Gelow-serafind/Homogenizer-Proj-ES-motor/doc/审核报告.md

# 审核报告 — ES 电机驱动板文档体系

> 当前 UI 复核：2026-10-08，结论与逐项问题见第 8 节；下方 2026-09-14 审核为历史记录。
> 审核日期：2026-09-14
> 审核范围：《产品认知摘要.md》《需求细分拆解.md》《详细测试用例.md》《软件架构设计.md》《CLAUDE.md》与需求原文（`es电机需求文档v1-260830.docx`、《产品需求简述.md》）的覆盖与一致性。
> 审核结论：**通过**（附 6 项待办问题，见第 6 节）。

---

## 1. 需求原文 ↔ 需求细分拆解 覆盖核对

《需求细分拆解.md》附录 B 已建立逐条映射表，核对结果：

| 来源 | 条目数 | 已映射 | 结论 |
|---|---|---|---|
| docx 原文段落（D1~D9） | 9 | 9 | ✓ 无遗漏 |
| 简述 一（部件认知） | 6 | 6 | ✓ |
| 简述 二（工作流程） | 6 | 6 | ✓ |
| 简述 三（软件开发需求点 A~H，1~27） | 27 | 27 | ✓ |
| docx 附加图标（▲ 常亮） | 1 | 1 | ✓（REQ-ICON-06，A7） |
| **合计** | **49** | **49** | **100% 覆盖** |

反向核查：47 条 REQ 全部有原文出处（每条标注"来源"），无凭空新增；原文缺失项（归零行为、边界行为、默认值等）均已标注 `[ASSUMPTION]` 并收敛于 A1~A17。

## 2. 需求跟踪矩阵（REQ ↔ TC）核查

| 核查项 | 结果 |
|---|---|
| REQ 总数 / TC 总数 | 47 / 57 |
| 每个 REQ ≥ 1 条 TC | ✓（正向矩阵 C.1 逐条核对通过，无"裸需求"） |
| 每条 TC 回指 ≥ 1 条 REQ | ✓（反向矩阵 C.2 逐条核对通过，无"无主用例"） |
| 三类场景覆盖 | ✓ 正常流 38 / 边界值 11 / 异常流 8 |
| 任务书点名场景 | ✓ 运行中停止（TC-SM-08）、运行中改参数（TC-SM-09/TC-MOT-05/TC-TIMER-04）、探头拔出（TC-TEMP-03/04）、断电重启（TC-STOR-01/04/05）、时间上限 9999:59:59（TC-IN-07）、转速上下限（TC-IN-05/06）、10rpm 步进（TC-IN-01/02） |
| 矩阵排版错误 | 已修复（C.2 表初稿存在 TC-SM-02~05 重复行，已更正为 19×3 无重复版） |

## 3. 需求 → 架构落点核查（47 条 REQ 逐条）

| REQ | 主模块 | 协同模块 | REQ | 主模块 | 协同模块 |
|---|---|---|---|---|---|
| DISP-01 | display | app_state | TIMER-01 | timer | app_state, speed_sensor |
| DISP-02 | display | — | TIMER-02 | timer | app_state |
| DISP-03 | display | — | TIMER-03 | timer | app_state, display |
| DISP-04 | display | temp_sensor | TIMER-04 | timer | app_state, motor |
| DISP-05 | display | app_state | ICON-01 | display | temp_sensor |
| DISP-06 | display | temp_sensor | ICON-02 | display | timer |
| DISP-07 | display | 全模块状态源 | ICON-03 | display | speed_sensor/motor |
| IN-01 | button | app_state | ICON-04 | display | app_state |
| IN-02 | button | app_state | ICON-05 | display | — |
| IN-03 | button | app_state | ICON-06 | display | app_state |
| IN-04 | button | app_state | STOR-01 | storage | app_state |
| IN-05 | button | app_state | STOR-02 | storage | app_state |
| IN-06 | button | app_state | STOR-03 | storage | — |
| IN-07 | button | app_state | STOR-04 | storage | app_state |
| SM-01 | app_state | — | SYS-01 | main 调度+event_bus | 全部模块 |
| SM-02 | app_state | button, display | SYS-02 | main（IWDG） | — |
| SM-03 | app_state | storage, display | SYS-03 | app_state | display |
| SM-04 | app_state | motor, timer, storage | | | |
| SM-05 | app_state | motor, timer, display | | | |
| SM-06 | app_state | motor, display | | | |
| SM-07 | app_state | motor, timer, storage | | | |
| SM-08 | app_state | storage, display | | | |
| MOT-01 | motor | app_state（目标）, speed_sensor（反馈，经事件总线 EVT_SPEED_UPDATED 缓存） | | | |
| MOT-02 | speed_sensor | display, app_state | | | |
| MOT-03 | app_state | speed_sensor, timer | | | |
| MOT-04 | motor | speed_sensor, display | | | |
| MOT-05 | motor | app_state | | | |
| TEMP-01 | temp_sensor | display | | | |
| TEMP-02 | temp_sensor | display | | | |
| TEMP-03 | temp_sensor | display, app_state | | | |

**结论**：47 条 REQ 全部有明确归属模块，无"无归属模块的业务逻辑"。

## 4. 文档间一致性核查

| # | 核查项 | 结论 |
|---|---|---|
| 1 | 编号体系统一（REQ/TC/A 系列跨文档引用一致） | ✓ |
| 2 | 状态机命名统一（STANDBY/RUNNING/PAUSED + 编辑层 SPEED→TIME_H→TIME_M→TIME_S） | ✓（四份文档一致，且与现有代码 `AppMode_t/SettingField_t` 对齐） |
| 3 | 周期参数统一（500ms 闪烁、5s 超时、10kHz PWM、2/10/5/50ms 现有任务） | ✓ |
| 4 | 假设编号 A1~A17 在《认知摘要》《拆解》《测试用例》《CLAUDE.md》间引用一致 | ✓（17/17 均在拆解中实际引用） |
| 5 | 关键行为口径统一：到达判定（A12）、暂停/恢复（A11）、归零（A4）、确认写 Flash（A15） | ✓ |
| 6 | 架构的"按钮事件需同时分发"要求：通过订阅广播 + app_state 编排 + 派生事件实现，与 4.3/4.4 信号流转图一致 | ✓ |
| 7 | 调度表与模块 `_ops` 签名一一对应（8 个周期任务 + dispatch） | ✓ |
| 8 | CLAUDE.md 与架构文档无矛盾（硬件速查与架构第 10 节一致） | ✓ |

## 5. [ASSUMPTION] 汇总清单

| # | 假设内容 | 影响 REQ | 确认建议 |
|---|---|---|---|
| A1 | 转速下限取 100 | IN-05, MOT-01 | **优先与客户确认** |
| A2 | 时间分位编辑（SPEED→H→M→S→SPEED 循环） | IN-02, IN-06 | **优先确认** |
| A3 | "目标温度/set temp"为笔误，仅保存转速+时间 | STOR-01 | 与客户确认 |
| A4 | 倒计时归零→自动停机回待机、参数保留 | TIMER-04 | **优先确认** |
| A5 | 十字架=PT1000 在位 | TEMP-03, ICON-01 | 确认 |
| A6 | 转速/H 钳位，M/S 循环 | IN-07 | 确认 |
| A7 | S3 为警告，恒灭；无独立运行箭头 | ICON-06 | 确认 |
| A8 | 感叹号恒灭+报警接口预留 | ICON-04, SYS-03 | 确认 |
| A9 | 停止后转速自然衰减显示至 0 | MOT-04, SM-05 | 低风险 |
| A10 | 每转脉冲数配置常量，实测标定 | MOT-02 | 硬件标定 |
| A11 | 未改时间续冻结值，改时间重载 | SM-07, TIMER-02 | 确认 |
| A12 | 到达判定 ≤50 RPM 且持续 ≥1s（**2026-09-17 起仅信息事件；倒计时改 START 直启**） | MOT-03, TIMER-01 | 标定后调参 |
| A13 | 默认转速 100、时间 00:00:00 | STOR-02 | 确认 |
| A14 | SPEED 实时生效、TIME 确认后生效 | MOT-05, TIMER-03 | 低风险 |
| A15 | 确认即写 Flash（单击/5s/START） | STOR-04 | 低风险 |
| A16 | 右上角 4 个图标 + 隔断线（按规格图纠正） | DISP-01 | 已按原文裁定 |
| A17 | 非编辑态旋转旋钮无效 | IN-07 | 低风险 |

## 6. 发现问题与遗留事项

| # | 问题 | 等级 | 处理建议 |
|---|---|---|---|
| I1 | `AGENTS.md` 仍描述旧板（TM1729/17.57kHz/长按启停），与本套文档冲突 | 中 | 本任务未授权修改；建议下次提交时同步或归档，避免误导 Codex |
| I2 | 用例 TC-MOT-01/02/03、TC-TEMP-01 依赖硬件与标定 | 中 | **R1 已关闭**（测速链路验证通 2026-09-14）、**A10 已关闭**（18 计数/圈，2026-09-15）；速度环已落地（2026-09-15）；**温度链路已实装**（2026-09-15 比值法+查表；段位校准完成 2026-09-16；**2026-10-01 探头接入，切实值显示待上板精度核对**；R2 通道归属关闭）；剩余 R7 LUT 标定、Kp/Ki 上板整定 |
| I3 | 现有代码为单文件 `main.c`（STEP3 实现），事件总线/模块拆分尚未落地 | 中 | 按架构第 11 节"迁移策略"逐模块切分，每步保持可编译、行为等价，同步更新 Keil `Project.uvprojx` |
| I4 | 到达判定当前用模型值 `MotorRpm==ConfigRpm`，非真实测速 | 高 | **已解决（2026-09-15）**：到达判定切换 speed_sensor 实测转速 + A12 容差（|实际−目标|≤50 RPM 持续 1s，`REACH_TOLERANCE_RPM/REACH_HOLD_MS`）；速度环（FF+PI，20ms/Q8）同批落地，反馈经 EVT_SPEED_UPDATED 订阅缓存；shell 新增 pid/pidkp/pidki 供上板整定 |
| I5 | 旧“30/30 图标全匹配”结论撤回（2026-10-08） | 中 | 规格图证实 S1/S2 对调、S3 误认运行箭头；已修正代码与文档并完成主机回归，待 Keil 编译与上板复核，详见第 8 节 |
| I6 | 17 项假设未获客户背书 | 中 | A1/A2/A4/A11 四项优先书面确认，确认结果回填《认知摘要》并在 `app_cfg.h` 单点落地 |

## 7. 结论

- 需求原文 49 个条目 100% 覆盖（47 条 REQ）；
- 47 REQ ↔ 58 TC 双向跟踪矩阵完整（2026-09-15 新增 TC-MOT-06 闭环动态响应），无裸需求、无无主用例；
- 47 条 REQ 全部在架构中有模块落点；
- 六份文档（含本报告）编号、命名、周期、假设引用一致；
- 遗留风险为 LUT 标定（R7）、Kp/Ki 上板整定与 4 项关键假设确认，均不阻塞编码，已列入待办。

**审核通过，可进入开发阶段。**

## 8. 2026-10-08 代码全盘走读与 UI 修复记录

### 8.1 范围与裁决依据

走读应用入口/调度、event_bus、app_state、display、button、motor、speed_sensor、temp_sensor、timer、storage，以及 ht1623、ads1115、ec11、flash_wear、uart_cmd。核对原始 docx 文本、六份需求/架构/测试文档和 LVD13083AVTP1 规格书第 3 页的图案/引脚矩阵。供应商 CMSIS/外设库作为平台依赖，未做逐行独立审计。

用户本次决策优先：暂停只关闭时钟与圆，Set Speed 保持显示；后续明确“需求未定义故障，先不显示感叹号”。因此本次不新增故障判断。正常拔出探头继续按既有需求隐藏温度和十字架。Instant Speed 沿用 A9 随实测衰减，不伪造瞬间静止。

### 8.2 已发现并修复的问题

| # | 错误与证据 | 修改 | 需求 / 测试 |
|---|---|---|---|
| UI-01 | S1/S2 角色对调：原 iconBind 时钟=1，常显标签=2；规格图 S1=Set Speed、S2=时钟。造成暂停标签灭、时钟常亮 | 常显标签改 S1，时钟改 S2 | DISP-01/07、ICON-02/06；TC-ICON-02/06 |
| UI-02 | S3 警告三角被当作“运行箭头”，正常 RUNNING 反而亮；警告 ROLE_WARN 绑定 0 | S3 绑定警告并恒灭，删除虚构的运行箭头角色；撤回旧“玻璃无感叹号”记录 | ICON-04/06；TC-ICON-04/06 |
| UI-03 | 圆只按平滑转速判亮，暂停后惯性阶段仍亮 | 圆=RUNNING 且实测转速>0，暂停/待机立即灭 | SM-05、ICON-03；TC-SM-08/ICON-03 |
| UI-04 | 时钟只看 RUNNING，时间为 0、不倒计时时仍亮 | 同时要求 timer active；非零时间 START 即亮 | ICON-02；TC-ICON-02/TIMER-06 |
| UI-05 | timer 只在进入秒处理前已为 0 时发归零事件，1→0 后多运行一秒 | 递减后当拍判零，下一状态机周期停机并关闭图标 | TIMER-04；TC-TIMER-05 |
| UI-06 | app_enter_edit 清 timeEdited：暂停改时间确认后，再进速度编辑会丢失重载标志 | 标志保留到 START 消费；未改时间仍续冻结值 | SM-07/TIMER-02；TC-SM-10/11 |
| UI-07 | 单击换字段只改 edit，未按 A15 确认保存；时间也没有确认生效 | 跳字段前 app_commit；时间只在改过时重载 | IN-02/STOR-04/TIMER-03；TC-IN-04/STOR-01/TIMER-04 |
| UI-08 | 首次/无效存储回显 0 RPM，与 A13/REQ-STOR-02 的 100 不一致 | 默认 RPM_MIN；旧记录低于下限时规范为 100，保留有效时间 | STOR-02；TC-STOR-02 |
| UI-09 | 吸附态使用最新 cfgRpm 绘制，改目标时会直接跳到新目标；原始零速还可能保持旧目标 4 拍 | 目标变化/零速立即退出旧吸附并对齐实测；重新满足条件后再吸附 | DISP-02；TC-DISP-02 扩展 |
| UI-10 | 每次 lcd_set_segment 都置 dirty，memcmp 相同没有清零，稳定画面仍每 50ms 写屏 | 用整帧比较结果覆盖 dirty；手动调试切回 auto 强制重写仍保留 | DISP-07/SYS-01；TC-SYS-01 扩展 |
| UI-11 | display 直接调用多个业务 getter，违反仅 app_state 白名单直调的架构要求 | app_state 10ms 汇总 display_view_t，display_set_view 复制；display 50ms 只渲染快照 | DISP-07/SYS-01；架构第 3/8 节 |
| UI-12 | 两 word 保存均读取可变 pending：快速再次确认时，可能把上一组 rpm/h 与下一组 m/s 混写；无变化确认也消耗槽 | 增加固定 writing 快照，新请求下一轮写；已完成且参数相同则跳过 | STOR-04；TC-STOR-04 扩展 |

其余 UI 核对：Set Speed/Instant Speed 右对齐与 Rpm、Set Time/Remaining 的 H4:M2:S2、500ms 编辑分位闪烁、5s 超时、START/STOP 退出闪烁、温度小数点/℃/标签随探头、隔断线常显，均保留并加入回归。纠正文档“100 的高两位熄灭”为最高一位熄灭。吸附宏实际为 ±5 RPM，文档旧写 ±2；本次保留固件现有阈值 5，仅同步注释/说明。

### 8.3 修正后的状态表

| 元素 | 待机 | 运行 | 暂停 |
|---|---|---|---|
| Set Speed 标签 S1、Rpm、设定数字 | 显示 | 显示 | 显示 |
| 时钟 S2 | 灭 | 非零倒计时 active 时亮 | 灭 |
| 感叹号 S3 | 灭 | 灭 | 灭 |
| 圆 S4 | 灭 | 实测 >0 时亮 | 立即灭（不等惯性停止） |
| 十字架 S30、温度区 | 随探头在位 | 随探头在位 | 随探头在位、继续测温 |
| Remaining | 启动前/归零后为 0 | 逐秒递减 | 冻结保持 |
| Instant Speed | 实测 | 实测平滑/吸附 | 实测衰减至 0 |

任一主状态下主动进入设置，仅当前数字字段闪烁；标签始终显示。

### 8.4 验证与未完成的硬件验收

- `python3 tests/test_ui.py`：编译真实 display/app_state/timer/storage/event_bus，替换 MCU/LCD/Flash/测速/温度硬件接口。通过 120 组状态/编辑/闪烁/探头/计时组合；按规格书坐标校验全部 28 位数字与 30 个图标；覆盖 0~9 字模及时间/温度边界、暂停惯性、冻结恢复、归零同拍、时间重载、单击持久化、5s 超时、吸附复位、稳定帧不重复写屏、调试恢复、并发确认快照与旧参数回显。
- `python3 tests/check_syntax.py`：按 Keil 工程 IncludePath/Define 对全部应用/入口/异常源文件运行 clang C99 语法检查；屏蔽宿主机 64 位与 CMSIS ARM 内联汇编宽度差异警告。此检查不汇编、不链接。
- **尚未执行**：Keil ARMCLANG V6.22 `-Oz` 完整编译、Flash/SRAM 剩余空间检查、烧录与 LCD 实物目视验收；当前环境无 Keil。未修改优化等级、引脚、PWM/PID，也未生成新的 hex/axf。
- 上板优先序列：待机→非零时间 START→仍有惯性时 STOP→恢复→归零；再测零时间运行、主动编辑闪烁、PT1000 拔插。S1/S2/S3 是此次必须复核的物理段位。

### 8.5 走读发现的既有遗留（未在本次 UI 修复中扩展）

- 温度 I2C 读取失败保持上次值，不能据当前软件区分“仍在位”与“读数过期”；故障范围尚未定义，本次未引入报警或新的温度故障界面。
- ADS1115 单次采样和 HT1623 位操作存在阻塞等待；本次修掉稳定屏重复发送，未重写外设驱动为异步状态机。
- 倒计时秒事件来自全局 housekeeping，START 首个显示秒的时长受全局相位影响；本次修正末秒停机延后，未改全局时基。
- IWDG 仍是 TODO；报警框架未实现；速度环 Kp/Ki、新电机 LUT 与温度精度仍需上板验收。既有 Flash 写满擦页的掉电窗口仍需硬件/存储设计专项验证。
- 此前“30/30 全匹配”的图标验收结论已撤回，当前修订依据规格图与主机段位回归，不能冒充上板通过。
