Gelow-serafind/Homogenizer-Proj-ES-motor/doc/需求细分拆解.md

# 需求细分拆解 — ES 电机驱动板

> **定位**：本文档是开发的唯一指导文档。完成的定义 = 完全覆盖《产品需求简述》的全部内容。
> **上游依据**：`doc/产品需求简述.md`（含 docx 原文摘录）、`doc/产品认知摘要.md`（歧义与假设清单 A1~A17）。
> **下游**：《详细测试用例.md》（每 REQ ≥ 1 条 TC）、《软件架构设计.md》（每 REQ 有模块落点）。
>
> **编号规则**：`REQ-<域>-<序号>`，域：DISP 显示 / IN 输入 / SM 状态机 / MOT 电机与测速 / TEMP 温度 / TIMER 倒计时 / ICON 图标 / STOR 存储 / SYS 系统级。
> **优先级**：P0 = 必须（缺失则产品不可用）；P1 = 应该（重要但可后期补）；P2 = 可选（预留/增强）。
> **假设标注**：涉及文档歧义的条目标注 `[ASSUMPTION An]`，编号与《产品认知摘要》第 4 节一致。
> **需求总量**：47 条。覆盖性核对表见文末附录 B。

---

## 1. 显示域（DISP）

### REQ-DISP-01 界面布局
- **描述**：屏面由 4 组数据区（Set Speed；Set Time；Instant Speed + Instant Temp；Remaining Time）、右上角图标区与常显隔断线组成。
- **来源**：简述 一「OLED 显示屏 显示 4 组数据区…+ 右上角 5 个状态图标区」；简述 三A-1「屏幕驱动与界面布局（4 数据区 + 图标区 + 隔断线常显）」。
- **验收标准**：上电后目视可见全部 4 组数据区标签与数字区、图标区、隔断线常亮（任何状态下）。
- **优先级**：P0
- **假设**：无（右上角 4 个图标及隔断线，见 [ASSUMPTION A16]）。

### REQ-DISP-02 转速字段格式
- **描述**：Set Speed 与 Instant Speed 均以 4 位数字 + `Rpm` 单位段显示，数字右对齐，高位空位熄灭。
- **来源**：简述 三A-2「字段格式化：转速 4 位 + "Rpm"」。
- **验收标准**：设定/显示 2000 → `2000Rpm`；100 → 最高一位熄灭 + `100Rpm`；单位段 `Rpm` 常显。
- **优先级**：P0
- **假设**：无。

### REQ-DISP-03 时间字段格式
- **描述**：Set Time 与 Remaining Time 按 `H(≤4位) m(2位) s(2位)` 显示，H/m/s 单位段按屏丝印点亮。
- **来源**：简述 三A-2「时间 HHHH H MM m SS s」；docx「倒计时时间最大：9999.59.59」。
- **验收标准**：设定 1:23:45 → H=0001、m=23、s=45；设定 9999:59:59 → 全字段正确显示；单位段常显。
- **优先级**：P0
- **假设**：无。

### REQ-DISP-04 温度字段格式
- **描述**：Instant Temp 按 `888.8℃` 格式显示（3 位整数 + 小数点 + 1 位小数 + ℃ 单位段）。
- **来源**：简述 一「PT1000 测温探头…格式 888.8℃」；简述 三A-2「温度 888.8℃」。
- **验收标准**：25.6℃ → 显示 ` 25.6℃`（高位空位熄灭）；小数位与 ℃ 段正确点亮。
- **优先级**：P0
- **假设**：无。

### REQ-DISP-05 编辑参数闪烁
- **描述**：进入设置后，当前编辑字段以 500ms 周期闪烁（亮/灭交替）；确认（单击跳字段 / 按 START / 5s 超时）后停止闪烁。
- **来源**：简述 二.2「数值闪烁」「任一参数闪烁 5 秒无操作 → 自动确认写入，停止闪烁」；简述 三A-3。
- **验收标准**：编辑字段按约 0.5s 周期可视闪烁，非编辑字段不闪烁；确认后闪烁停止且字段显示新值。
- **优先级**：P0
- **假设**：无。

### REQ-DISP-06 温度整块隐藏
- **描述**：PT1000 拔出时，Instant Temp 的 `888.8℃` 数字连同标签整块熄灭；探头插回后恢复显示当前温度。
- **来源**：简述 三A-4；docx「如果拔掉了PT1000，字符"instant temp 888.8°C"全不显示」。
- **验收标准**：拔出探头 → 温度数字、标签、℃ 段全部熄灭；插回 → 恢复显示且数值为当前读数。
- **优先级**：P0
- **假设**：无（隐藏判定依赖 REQ-TEMP-03 开路检测）。

### REQ-DISP-07 图标渲染联动
- **描述**：图标区渲染由系统状态事件驱动，状态逻辑遵循 REQ-ICON-01 ~ REQ-ICON-06。
- **来源**：简述 三A-5「图标渲染与状态联动（见 E）」。
- **验收标准**：图标状态变化与对应状态事件一致（以 REQ-ICON 系列验收标准为准）。
- **优先级**：P0
- **假设**：无。

---

## 2. 输入域（IN）

### REQ-IN-01 旋钮旋转解码
- **描述**：EC11 正交解码（4 倍频），顺时针产生 +1 增量、逆时针产生 −1 增量，带去抖；增量只作用于当前编辑字段。
- **来源**：简述 一「旋转=改参数（顺时针增大/逆时针减小）」；简述 三B-6「编码器旋转解码（CW+/CCW−、防抖、只作用于当前闪烁参数）」。
- **验收标准**：每格旋转对应 +1/−1 增量（speed 字段 ±10 RPM）；快速连续旋转不丢步、不误判方向。
- **优先级**：P0
- **假设**：无。

### REQ-IN-02 旋钮单击切换字段
- **描述**：非编辑状态下单击旋钮进入设置并编辑 SPEED；编辑状态下单击确认当前字段并切换到下一字段，循环顺序 SPEED → TIME_H → TIME_M → TIME_S → SPEED。
- **来源**：简述 一「单击=确认并跳到下一个参数」；简述 三B-7「旋钮短按：确认并跳下一参数（speed → time → speed 循环）」。
- **验收标准**：连续单击 4 次完成一个字段循环；每次单击后闪烁位置与顺序一致。
- **优先级**：P0
- **假设**：时间分位循环按 [ASSUMPTION A2]；进入设置的完整路径见 REQ-SM-02/06/07。

### REQ-IN-03 START 键扫描去抖
- **描述**：START 键（PA2，低有效）扫描去抖，按下沿产生唯一"开始"事件，长按不重复触发。
- **来源**：简述 三B-8「START / STOP 按键扫描去抖」；docx「"开始"设置为参数后，按下开始工作」。
- **验收标准**：单次按下只产生 1 次事件；连按/抖动不产生重复或漏触发；长按 3s 以上仍只触发 1 次。
- **优先级**：P0
- **假设**：无。

### REQ-IN-04 STOP 键扫描去抖
- **描述**：STOP 键（PD7，低有效）扫描去抖，按下沿产生唯一"停止/暂停"事件。
- **来源**：简述 三B-8；docx「"停止"运动中停止」。
- **验收标准**：同 REQ-IN-03 的判定方式。
- **优先级**：P0
- **假设**：无。

### REQ-IN-05 转速范围与步进
- **描述**：目标转速范围 100 ~ 2000 RPM，步进 10 RPM。
- **来源**：简述 三B-9「数值范围约束：转速 100/200~2000、步进 10rpm」；docx「电机转速范围：100/200~2000，加减最小细分10rpm」。
- **验收标准**：每次旋转 ±10 RPM；最小可设定 100、最大 2000；中间值可精确到达（如 1010）。
- **优先级**：P0
- **假设**：下限取 100 见 [ASSUMPTION A1]。

### REQ-IN-06 时间范围与编辑
- **描述**：倒计时时间上限 9999:59:59；H（0~9999）、M（0~59）、S（0~59）分位独立编辑。
- **来源**：简述 三B-9「时间上限 9999:59:59」；docx「倒计时时间最大：9999.59.59」。
- **验收标准**：可设定并显示 9999:59:59；各分位可独立加减。
- **优先级**：P0
- **假设**：分位编辑见 [ASSUMPTION A2]；边界行为见 REQ-IN-07 与 [ASSUMPTION A6]。

### REQ-IN-07 编辑边界与非编辑态行为
- **描述**：转速到边界后继续旋转保持钳位（不循环）；H 钳位 0~9999；M/S 在 0~59 循环；非编辑状态下旋转旋钮无效。
- **来源**：文档未定义（歧义缺失项）。
- **验收标准**：在 100 处逆时针、2000 处顺时针，数值保持不变；M/S 59 再加变 0、0 再减变 59；待机/运行非编辑态旋转，所有参数与显示不变。
- **优先级**：P1
- **假设**：[ASSUMPTION A6]、[ASSUMPTION A17]。

---

## 3. 主状态机域（SM）

### REQ-SM-01 状态集合
- **描述**：系统状态由主模式（STANDBY / RUNNING / PAUSED）与编辑叠加层（EDIT_NONE / EDIT_SPEED / EDIT_TIME_H / EDIT_TIME_M / EDIT_TIME_S）正交组成；编辑层可在任一主模式下激活。
- **来源**：简述 三C-10「主状态机：待机 → 参数编辑（speed/time 子状态）→ 运行 → 运行中编辑 → 停止/暂停」。
- **验收标准**：任何时刻系统处于且仅处于一个主模式 + 一个编辑层状态（共 3×5=15 组合），观察行为与状态定义一致。
- **优先级**：P0
- **假设**：无。

### REQ-SM-02 进入设置
- **描述**：非编辑状态下单击旋钮 → 进入编辑层，SPEED 字段闪烁（待机/暂停/运行中均可用；运行中电机保持原目标运行）。
- **来源**：简述 二.2、二.4、二.5；docx「首次开机，单击旋钮，进入Set speed设置」。
- **验收标准**：待机单击 → SPEED 闪；暂停单击 → SPEED 闪；运行中单击 → SPEED 闪且电机不停止。
- **优先级**：P0
- **假设**：无。

### REQ-SM-03 5s 无操作自动确认
- **描述**：编辑状态下 5s 无任何操作（旋转/单击均重置计时）→ 自动确认写入、停止闪烁、退出编辑层（回到进入前的主模式）。
- **来源**：简述 二.2、三C-13；docx「如果参数闪烁5s，也表示确认参数写入，停止闪烁」。
- **验收标准**：最后一次操作后 5s ±0.5s 停闪退出；旋转或单击后重新计时满 5s 才退出；退出后参数已持久化。
- **优先级**：P0
- **假设**：无。

### REQ-SM-04 START 全局启动
- **描述**：任意状态（含参数闪烁中）按 START → 立即启动/恢复运行：确认写入、停止闪烁、退出编辑层、电机向目标转速运行。
- **来源**：简述 三C-11「全局规则：任意闪烁状态下按 START 即启动」；docx「不管它在哪个参数在闪，只要按了开始，然后它就能启动」。
- **验收标准**：待机/设置中/暂停三种时刻按 START 均能启动或恢复，闪烁立即停止，无延迟。
- **优先级**：P0
- **假设**：无。

### REQ-SM-05 运行中 STOP 暂停
- **描述**：RUNNING 状态下按 STOP → 进入 PAUSED：电机停转、倒计时冻结、时钟/圆 图标熄灭、实时温度继续显示、实时转速衰减显示至 0。
- **来源**：简述 二.5；docx「运动中单击停止键，设备电机停止…倒计时的时间暂停」。
- **验收标准**：按 STOP 后电机停转（PWM 输出归零），图标按上述联动，剩余时间保持按下时刻的值不变。
- **优先级**：P0
- **假设**：转速显示衰减见 [ASSUMPTION A9]。

### REQ-SM-06 运行中进入设置（电机不停）
- **描述**：RUNNING 状态下单击旋钮 → 进入编辑层，电机按原目标继续运行；退出编辑层前电机行为不受编辑影响（除 SPEED 实时跟随，见 REQ-MOT-05）。
- **来源**：简述 二.4；docx「运行中，按下旋钮键，进入设置参数界面」。
- **验收标准**：进入/退出编辑层全程电机不停止；不改参数时实际转速无变化。
- **优先级**：P0
- **假设**：无。

### REQ-SM-07 暂停后的转换路径
- **描述**：PAUSED 状态下：单击旋钮 → 进入设置，改了哪个参数就按哪个新参数执行；直接按 START → 按当前目标继续工作。
- **来源**：简述 三C-12「停止 → 进设置 → 改参数 → 再启动的转换路径」；docx「改了其中的参数就按新参数重新运行，直接点开始键，就开始工作」。
- **验收标准**：暂停中改转速后 START → 按新转速运行；暂停中改时间后 START → 倒计时按新值重载；未改直接 START → 按原目标继续（倒计时从冻结值继续，见 A11）。
- **优先级**：P0
- **假设**：[ASSUMPTION A11]。

### REQ-SM-08 上电初始状态
- **描述**：上电 → STANDBY，不自动启动；回显上次目标转速/时间；实时转速 0、倒计时 0、实时温度当前读数；图标：十字架按探头实况、时钟/圆 灭、隔断线常显、感叹号不显示。
- **来源**：简述 二.1、二.6；docx「二次开机…客户直接点击开始键，设备可以直接开始工作」。
- **验收标准**：上电后电机不转，显示与图标状态符合上述，按 START 即可直接启动。
- **优先级**：P0
- **假设**：无。

---

## 4. 电机控制与测速域（MOT）

### REQ-MOT-01 转速闭环控制
- **描述**：目标转速 100~2000 RPM、分辨率 10 RPM；闭环使实际转速稳定跟随目标（PWM 10kHz、TIM1_CH2；RPM-占空比 LUT 标定）。**实现方案（2026-09-15 落地）**：FF(LUT 前馈) + PI 反馈并联结构，20ms 节拍（与测速反馈同频）、Q8 定点无浮点；反馈经事件总线订阅 EVT_SPEED_UPDATED 缓存（motor_on_event）；参考轨迹=原 ramp（1000 RPM/s，启动无阶跃；**2026-09-17 修复：STOP 后重启动按实测转速复位，消除大电流猛启动**）；积分限幅抗饱和、输出限幅 SPEED_LOOP_DUTY_MAX（兼堵转保护）；Kp/Ki 常量集中 app_cfg.h 并经 shell pidkp/pidki 上板整定。
- **来源**：简述 三D-14「转速闭环控制（目标范围、10rpm 分辨率）」；docx「电机转速范围：100/200~2000，加减最小细分10rpm」。
- **验收标准**：各档位（如 100/500/1000/2000）稳态下实测转速在标定容差内（±5% 或标定值）；10 RPM 一档变化可分辨。
- **优先级**：P0
- **假设**：[ASSUMPTION A1]。

### REQ-MOT-02 光电测速
- **描述**：采集光耦脉冲信号，按每转脉冲数换算 RPM，滤波后刷新 Instant Speed。
- **来源**：简述 一「光电测速 检测电机实际转速，推算实时 RPM」；简述 三D-15「光电信号测速、RPM 推算与滤波」；docx「instant speed实时检测速度，由光电信号检测推算」。
- **验收标准**：低速手转电机与运行状态下，Instant Speed 与外部参考转速计一致（±容差），刷新连续无明显跳变。
- **优先级**：P0
- **假设**：每转脉冲数配置见 [ASSUMPTION A10]。

### REQ-MOT-03 到达目标判定
- **描述**：实际转速达到目标值（|实际−目标| ≤ 容差且持续 ≥ 稳定时间）→ post(EVT_REACH_TARGET) 信息事件（当前无消费方，供后续功能如到达提示使用）。
- **来源**：简述 二.3「实际转速到达目标值后，剩余时间才从设定值开始倒计时」；简述 三D-16。**2026-09-17 用户上板实测决策**：倒计时改为 START 直启，到达判定不再触发倒计时（事件保留）。
- **验收标准**：到达瞬间不引起倒计时/显示/电机任何跳变；事件在 |实际−目标|≤50 RPM 持续 1s 时发布（内部回归验证）。
- **优先级**：P1（原 P0；倒计时不再依赖，2026-09-17 降级）
- **假设**：[ASSUMPTION A12]（容差 50 RPM / 持续 1s，初值）。

### REQ-MOT-04 停止控制
- **描述**：STOP 后电机受控停转（PWM 归零），Instant Speed 随测速自然衰减显示至 0，圆图标在 STOP 进入暂停后立即熄灭（2026-10-08 用户决策）。
- **来源**：简述 三D-17「停机控制（STOP 后受控停转，转速显示归 0）」；docx「转速实时显示直到显示0」。
- **验收标准**：按 STOP 后电机停转，Instant Speed 由当前值连续衰减至 0（不瞬时跳 0），圆图标熄灭。
- **优先级**：P0
- **假设**：[ASSUMPTION A9]。

### REQ-MOT-05 运行中目标转速平滑跟随
- **描述**：运行中编辑 SPEED，每步 ±10 RPM 立即更新目标，闭环平滑过渡（斜坡逼近），无停机、无阶跃突变。
- **来源**：简述 三D-18「运行中目标转速变更的平滑跟随」；docx「SPEED参数闪烁，转速根据参数变化」。
- **验收标准**：运行中旋转旋钮，实际转速连续平滑变化至新目标，全程电机不停止、占空比无突变。
- **优先级**：P0
- **假设**：[ASSUMPTION A14]。

---

## 5. 温度采集域（TEMP）

### REQ-TEMP-01 PT1000 采集
- **描述**：采集 PT1000 分压信号，反推阻值换算温度，分辨率 0.1℃，按 888.8℃ 格式显示。
- **实现（2026-09-15；2026-10-01 探头接入切实值显示）**：原理图核实电路 = VCC_5V—R16(1k)—ADC_PT1000+（CN3）—GND，AIN0=探头节点、AIN1=R19/R18 基准中点；**比值法** `R_t=1000×A0/(2×A1−A0)`（免疫电源波动）；温度 = IEC 60751 生成表（0~300℃/5℃ 步进）+ 线性插值（℃，×10 定点，零浮点）；0.1℃ 小数点段 S28/℃ 段 S29 已实测绑定（2026-09-16）；`TEMP_DISPLAY_PLACEHOLDER` 已切 0 显示实测值（拔出整块隐藏）。
- **来源**：简述 三F-19「PT1000 采集、0.1℃ 分辨率」；docx「PT1000的实时温度读取」。
- **验收标准**：温度显示与标准温度计（或精密电阻标定）偏差 ≤ ±1℃；最小显示单位 0.1℃。
- **优先级**：P0
- **假设**：无。

### REQ-TEMP-02 全状态实时刷新
- **描述**：待机/设置/运行/暂停所有状态下，温度均按周期持续刷新。
- **来源**：简述 三F-19「全状态实时刷新」；简述 二.5「实时温度继续正常显示」。
- **验收标准**：运行与暂停期间用手温改变探头温度，显示值随之变化（刷新周期 ≤1s）。
- **优先级**：P0
- **假设**：无。

### REQ-TEMP-03 探头在位检测
- **描述**：通过 ADC 开路电压阈值判定探头插入/拔出；拔出 → 温度字段整块隐藏 + 十字架图标灭；插入 → 恢复显示 + 十字架亮。
- **来源**：简述 三F-20「探头在位检测（联动 E/F 的隐藏逻辑）」；docx「"十字架"传感器，插入就亮，不插就不亮」。
- **验收标准**：拔插探头，显示与图标在 ≤1s 内联动切换。
- **优先级**：P0
- **假设**：[ASSUMPTION A5]。

---

## 6. 倒计时域（TIMER）

### REQ-TIMER-01 启动条件
- **描述**：倒计时在按 START（进入 RUNNING）时立即启动：全新启动从设定值开始、暂停恢复从冻结值继续、改过时间按新值重载；启动后每秒递减 1s；时间为 0:00:00 时不递减（无计时作业，也不触发归零）。
- **来源**：简述 三G-21「启动条件：转速到达目标值后才倒数」；docx「Remaining time 运行后，速度到目标值的开始倒计时」。**2026-09-17 用户上板实测决策变更**：改为"点击 START 立即开始倒计时，点击 STOP 停止倒计时"（不再等待转速到达）。
- **验收标准**：按 START 后 ≤1s 内 Remaining 开始按 1Hz 递减（不等转速到达）；按 STOP 立即冻结；时间设 0 时启动不倒数、不归零。
- **优先级**：P0
- **假设**：[ASSUMPTION A12]（判定保留为信息事件，不再触发倒计时）。

### REQ-TIMER-02 暂停保持
- **描述**：STOP 后倒计时暂停并保持当前剩余值，不清零。
- **来源**：简述 三G-22「停止时暂停并保持剩余值」；docx「倒计时的时间暂停」。
- **验收标准**：暂停后等待 ≥10s，Remaining Time 显示值与暂停时刻完全一致。
- **优先级**：P0
- **假设**：无。

### REQ-TIMER-03 运行中改时间刷新
- **描述**：运行中修改时间并确认（单击跳字段/5s 超时/STOP/START）后，倒计时按新值重载并从新值立即继续递减。
- **来源**：简述 三G-23「运行中改时间后，退出设置界面时倒计时刷新」；docx「设置了time，也是按实时参数写入…退出设置界面，实时速度和实时倒计时需要更新」。
- **验收标准**：运行中把时间从 00:10:00 改为 00:05:00，退出编辑后 Remaining Time 立即显示 00:05:00 并从新值继续逐秒递减。
- **优先级**：P0
- **假设**：[ASSUMPTION A14]。

### REQ-TIMER-04 归零行为
- **描述**：倒计时归零 → 自动停机：电机停转、倒计时保持 0、状态回 STANDBY、设定参数保留；时钟/圆 图标熄灭。
- **来源**：文档未定义（简述 G-24 缺失项）。
- **验收标准**：归零瞬间电机停转，状态机回到待机；可再次按 START 按原参数重新工作。
- **优先级**：P1
- **假设**：[ASSUMPTION A4]。

---

## 7. 图标逻辑域（ICON）

### REQ-ICON-01 十字架
- **描述**：十字架图标 = PT1000 探头插入状态：插入亮、拔出灭。
- **来源**：简述 E 图标表「传感器插入检测，插则亮、拔则灭」。
- **验收标准**：与 REQ-TEMP-03 的拔插联动一致。
- **优先级**：P0
- **假设**：[ASSUMPTION A5]。

### REQ-ICON-02 时钟
- **描述**：时钟 S2 仅 RUNNING 且倒计时 active 时亮；暂停/待机/零时间运行灭。
- **来源**：docx「开始倒计时时候亮，不倒计时不用」；2026-10-08 用户明确时钟表示倒计时。
- **验收标准**：非零时间 START 即亮（含加速段）；STOP/归零即灭；零时间持续运行不亮。
- **优先级**：P0
- **假设**：无。

### REQ-ICON-03 圆
- **描述**：圆 S4 仅 RUNNING 且实测转速 >0 时亮；暂停/待机立即灭，不等待惯性停转。
- **来源**：2026-10-08 用户暂停显示决策，覆盖原随惯性熄灭规则。
- **验收标准**：STOP 后下一次业务刷新圆灭；Instant Speed 仍按 A9 显示实测衰减。
- **优先级**：P0
- **假设**：无。

### REQ-ICON-04 感叹号
- **描述**：感叹号图标 S3 本版本固定不显示（2026-10-08 用户再次确认：不新增故障判断）（预留报警位）。
- **来源**：简述 E「感叹号 本版本固定不显示（预留报警位）」；docx「"感叹号"报警，本版本不用，一直不显示」。
- **验收标准**：所有状态下感叹号均不可见。
- **优先级**：P0
- **假设**：[ASSUMPTION A8]。

### REQ-ICON-05 隔断线
- **描述**：隔断线 `----` 在所有状态下常显。
- **来源**：简述 E「隔断线 常显」；docx「"----"隔断线，一直显示」。
- **验收标准**：所有状态下隔断线均可见。
- **优先级**：P0
- **假设**：无。

### REQ-ICON-06 图标物理绑定与常显标签（原“向上图标”条目纠正）
- **描述**：S1=Set Speed 标签常显；S2=时钟；S3=警告三角感叹号（按 REQ-ICON-04 恒灭）；S4=圆；S30=十字架。无独立运行箭头。
- **来源**：屏规格书第 3 页 + 2026-10-08 用户反馈，纠正 A7/A16 旧推断。
- **验收标准**：暂停时 S1 保持，S2/S4 灭，S3 恒灭；S30 按探头。Set Speed 数值仅在主动编辑该字段时闪烁。
- **优先级**：P0
- **假设**：[ASSUMPTION A7]、[ASSUMPTION A16] 已由规格图纠正。

---

## 8. 参数存储域（STOR）

### REQ-STOR-01 断电保存与回显
- **描述**：目标转速 + 目标时间（H/M/S）持久化于片上 Flash；上电自动恢复并回显。
- **来源**：简述 三H-25「目标转速/时间断电保存（EEPROM/Flash），上电回显」；docx「再次上电开机，显示上次设置的目标…和目标时间」。
- **验收标准**：设置 → 断电 → 上电后 Set Speed/Set Time 与上次一致；可立即 START 工作。
- **优先级**：P0
- **假设**：[ASSUMPTION A3]（无温度参数）。

### REQ-STOR-02 首次上电默认值
- **描述**：Flash 无有效记录（出厂/擦除）时，使用默认参数：转速 100、时间 00:00:00。
- **来源**：简述 二.1「首次上电：显示默认参数」（值未定义）。
- **验收标准**：擦除 Flash 后首次上电显示默认值，且不崩溃、可正常设置。
- **优先级**：P1
- **假设**：[ASSUMPTION A13]。

### REQ-STOR-03 写入磨损均衡
- **描述**：参数写入采用末页 slot 轮转 + 写满整页擦除的磨损均衡策略。
- **来源**：简述 三H-26「写入磨损与掉电保护」。
- **验收标准**：连续修改参数 ≥50 次，数据始终正确；写满 32 槽后自动整页擦除并继续正确保存。
- **优先级**：P1
- **假设**：无。

### REQ-STOR-04 写入时机与掉电保护
- **描述**：确认时机（单击跳字段 / 5s 超时 / 按 START）触发写入；写入过程中断电不损坏既有有效记录（上电按最后有效记录恢复）。
- **来源**：简述 三H-26；docx「参数闪烁5s，也表示确认参数写入」。
- **验收标准**：未确认的修改断电后不生效；确认后修改断电可恢复；写入瞬间反复断电 10 次，参数回退到最近一次完整记录，不出现乱码。
- **优先级**：P1
- **假设**：[ASSUMPTION A15]。

---

## 9. 系统级域（SYS）

### REQ-SYS-01 非阻塞架构
- **描述**：超级循环 + 协作式任务调度，任何模块不得使用阻塞延时；外设异常（I2C 无响应等）不影响按键/显示等其余功能。
- **来源**：简述 三H-27「非阻塞架构」。
- **验收标准**：模拟 I2C 通信异常时，屏幕刷新与按键响应保持正常，系统不卡死。
- **优先级**：P0
- **假设**：无。

### REQ-SYS-02 看门狗
- **描述**：启用独立看门狗（IWDG），正常运行时周期喂狗；程序跑飞后触发复位。
- **来源**：简述 三H-27「看门狗」。
- **验收标准**：长时间运行（≥24h）无异常复位；人为注入死循环后芯片复位重启。
- **优先级**：P1
- **假设**：无。

### REQ-SYS-03 报警框架预留
- **描述**：预留故障检测接口（超温 / 失速 / 探头脱落候选），本版本只采集与记录，不点亮感叹号。
- **来源**：简述 三H-27「预留报警框架（感叹号图标位）」。
- **验收标准**：故障注入后系统状态可通过调试接口读取，感叹号保持不显示。
- **优先级**：P2
- **假设**：[ASSUMPTION A8]。

---

## 附录 A：ASSUMPTION 汇总

| 编号 | 内容 | 影响条目 |
|---|---|---|
| A1 | 转速下限取 100 | REQ-IN-05, REQ-MOT-01 |
| A2 | 时间分位编辑：SPEED→H→M→S→SPEED 循环 | REQ-IN-02, REQ-IN-06 |
| A3 | "目标温度/set temp" 为笔误，回显转速+时间 | REQ-STOR-01 |
| A4 | 倒计时归零 → 自动停机回待机、参数保留 | REQ-TIMER-04 |
| A5 | 十字架 = PT1000 在位 | REQ-TEMP-03, REQ-ICON-01 |
| A6 | 转速/H 钳位，M/S 循环 | REQ-IN-07 |
| A7 | S3 为警告，恒灭；无独立运行箭头 | REQ-ICON-06 |
| A8 | 感叹号恒灭 + 报警接口预留 | REQ-ICON-04, REQ-SYS-03 |
| A9 | 停止后转速自然衰减显示至 0 | REQ-MOT-04, REQ-SM-05 |
| A10 | 每转脉冲数为配置常量，实测标定（**已实测：18 计数/圈，2026-09-15**） | REQ-MOT-02 |
| A11 | 未改时间继续冻结值；改时间按新值重载 | REQ-SM-07 |
| A12 | 到达判定：≤50 RPM 且持续 ≥1s（**2026-09-17 起仅信息事件，倒计时改 START 直启**） | REQ-MOT-03, REQ-TIMER-01 |
| A13 | 默认转速 100、时间 00:00:00 | REQ-STOR-02 |
| A14 | SPEED 实时生效；TIME 确认后生效 | REQ-MOT-05, REQ-TIMER-03 |
| A15 | 确认即写 Flash（单击/5s/START） | REQ-STOR-04 |
| A16 | 右上角 4 个图标 + 隔断线（按规格图纠正） | REQ-DISP-01 |
| A17 | 非编辑态旋转旋钮无效 | REQ-IN-07 |

---

## 附录 B：覆盖性核对表

### B.1 docx 原文段落（D1~D9）

| 条目 | 原文摘录 | 对应 REQ | ✓ |
|---|---|---|---|
| D1 | 按键说明：开始/停止/旋钮（逆时针小顺时针大，按下确认换下一参数） | REQ-IN-01, IN-02, IN-03, IN-04, SM-04, SM-05 | ✓ |
| D2 | 右上角图标：十字架/时钟/感叹号/圆/---- | REQ-ICON-01, 02, 03, 04, 05 | ✓ |
| D3 | 各字段说明（Set speed/Set time/instant speed/instant temp 拔出全不显示/Remaining time 到达后倒计时） | REQ-DISP-02/03/04/06, MOT-02, TEMP-01/03, TIMER-01 | ✓ |
| D4 | 转速 100/200~2000 步进 10；时间最大 9999.59.59 | REQ-IN-05, IN-06, MOT-01 | ✓ |
| D5 | 首次开机设置流程、5s 闪烁确认、开始键启动、图标点亮、▲常亮 | REQ-SM-02/03/04, DISP-05, ICON-02/03/06, STOR-04 | ✓ |
| D6 | 运行中停止：图标熄灭、温度显示、转速显示到 0、倒计时暂停；停止后设置/直接开始 | REQ-SM-05/07, MOT-04, TIMER-02, TEMP-02 | ✓ |
| D7 | 运行中设置：SPEED 闪烁转速随参数变化、time 5s 写入、退出后实时值更新 | REQ-SM-06, MOT-05, TIMER-03 | ✓ |
| D8 | 二次开机回显、实时温度当前值、实时转速 0、倒计时 0、图标状态、直接开始可工作 | REQ-SM-08, STOR-01, ICON-01/02/03 | ✓ |
| D9 | 任何闪烁按开始即启动；暂停保持参数 | REQ-SM-04, SM-07, TIMER-02 | ✓ |

### B.2 简述 一（部件认知）

| 条目 | 原文摘录 | 对应 REQ | ✓ |
|---|---|---|---|
| S1-1 | OLED 显示屏 4 数据区 + 图标区 | REQ-DISP-01 | ✓ |
| S1-2 | 旋转编码器：旋转改参、单击确认跳参 | REQ-IN-01, IN-02 | ✓ |
| S1-3 | START/STOP：启动/停止（兼暂停） | REQ-IN-03, IN-04, SM-04, SM-05 | ✓ |
| S1-4 | 电机：目标转速可设，闭环调速 | REQ-MOT-01 | ✓ |
| S1-5 | 光电测速：推算实时 RPM | REQ-MOT-02 | ✓ |
| S1-6 | PT1000：实时温度 888.8℃ | REQ-TEMP-01, DISP-04 | ✓ |

### B.3 简述 二（工作流程 1~6）

| 条目 | 原文摘录 | 对应 REQ | ✓ |
|---|---|---|---|
| S2-1 | 上电待机（默认/恢复、初始显示、图标、可一键启动） | REQ-SM-08, STOR-01/02, ICON-01/02/03/05 | ✓ |
| S2-2 | 参数设置（进入/闪烁/旋转/步进/范围/循环/5s 确认） | REQ-SM-02/03, IN-01/02/05/06, DISP-05 | ✓ |
| S2-3 | 启动运行（任意时刻开始、图标、实时转速、到达后倒计时） | REQ-SM-04, MOT-02/03, TIMER-01, ICON-02/03/06 | ✓ |
| S2-4 | 运行中在线调节（电机不停、转速实时跟随、time 5s 生效、退出刷新） | REQ-SM-06, MOT-05, TIMER-03 | ✓ |
| S2-5 | 停止/暂停（图标灭、转速显示 0、倒计时保持、温度继续、停止后路径） | REQ-SM-05/07, MOT-04, TIMER-02, TEMP-02, ICON-02/03 | ✓ |
| S2-6 | 断电恢复（回显、直接开始可工作） | REQ-STOR-01, SM-08 | ✓ |

### B.4 简述 三（软件开发需求点 1~27）

| 条目 | 原文 | 对应 REQ | ✓ |
|---|---|---|---|
| A-1 | 屏幕驱动与界面布局（4 数据区 + 图标区 + 隔断线常显） | REQ-DISP-01, ICON-05 | ✓ |
| A-2 | 字段格式化（4 位 Rpm / H-M-S / 888.8℃） | REQ-DISP-02/03/04 | ✓ |
| A-3 | 编辑闪烁、5s 停闪自动写入 | REQ-DISP-05, SM-03, STOR-04 | ✓ |
| A-4 | PT1000 拔出温度整块隐藏 | REQ-DISP-06, TEMP-03 | ✓ |
| A-5 | 图标渲染与状态联动 | REQ-DISP-07, ICON-01~06 | ✓ |
| B-6 | 编码器旋转解码（CW/CCW、防抖、只作用于当前闪烁参数） | REQ-IN-01 | ✓ |
| B-7 | 旋钮短按确认跳下一参数 | REQ-IN-02 | ✓ |
| B-8 | START/STOP 扫描去抖 | REQ-IN-03, IN-04 | ✓ |
| B-9 | 数值范围：转速 100/200~2000 步进 10；时间上限 9999:59:59 | REQ-IN-05, IN-06 | ✓ |
| C-10 | 主状态机（待机→编辑→运行→运行中编辑→停止/暂停） | REQ-SM-01, SM-06 | ✓ |
| C-11 | 任意闪烁状态下按 START 即启动 | REQ-SM-04 | ✓ |
| C-12 | 停止→设置→改参→再启动路径 | REQ-SM-07 | ✓ |
| C-13 | 5s 无操作自动确认 | REQ-SM-03 | ✓ |
| D-14 | 转速闭环控制（范围、10rpm 分辨率） | REQ-MOT-01 | ✓ |
| D-15 | 光电测速、RPM 推算与滤波 | REQ-MOT-02 | ✓ |
| D-16 | 到达目标判定（触发倒计时 + 圆图标） | REQ-MOT-03, TIMER-01, ICON-03 | ✓ |
| D-17 | 停机控制（受控停转、显示归 0） | REQ-MOT-04 | ✓ |
| D-18 | 运行中目标变更平滑跟随 | REQ-MOT-05 | ✓ |
| E 表 | 十字架/时钟/圆/感叹号/隔断线 | REQ-ICON-01~05 | ✓ |
| F-19 | PT1000 采集 0.1℃ 全状态实时 | REQ-TEMP-01, TEMP-02 | ✓ |
| F-20 | 探头在位检测（联动隐藏逻辑） | REQ-TEMP-03 | ✓ |
| G-21 | 到达目标后才倒数 | REQ-TIMER-01 | ✓ |
| G-22 | 停止暂停保持剩余值 | REQ-TIMER-02 | ✓ |
| G-23 | 运行中改时间退出刷新 | REQ-TIMER-03 | ✓ |
| G-24 | 归零行为（文档缺失） | REQ-TIMER-04 [ASSUMPTION A4] | ✓ |
| H-25 | 断电保存上电回显、首次默认 | REQ-STOR-01, STOR-02 | ✓ |
| H-26 | 写入磨损与掉电保护 | REQ-STOR-03, STOR-04 | ✓ |
| H-27 | 非阻塞、看门狗、预留报警框架 | REQ-SYS-01, SYS-02, SYS-03 | ✓ |
| — | docx 启动段"向上图标常亮"（图标表未定义） | REQ-ICON-06 [ASSUMPTION A7] | ✓ |

**核对结论**：需求文档原文（docx D1~D9、简述 一/二/三 全部条目）均映射至至少 1 条 REQ，无遗漏；全部 47 条 REQ 均有原文来源，无凭空新增。

## 2026-10-08 UI 回归补充（沿用现有 REQ）

- REQ-DISP-07/SYS-01：稳定画面不重复写屏；调试切回自动时强制刷新；业务显示由 app_state 经白名单推送快照，display 不跨模块拉取。
- REQ-SM-07/TIMER-02：暂停改时间确认后，再进入 SPEED 设置不能丢失“下次启动重载新时间”标志。
- REQ-IN-02/STOR-04：单击跳字段先确认当前参数；TIME 确认后按 REQ-TIMER-03 重载，未再改时间不重复重载。
- REQ-TIMER-04：由 1 秒减至 0 的同一秒节拍发归零事件，下一次状态机处理停机，不额外等待一秒。
- REQ-DISP-02：修改目标转速立即取消旧目标吸附，重新按实测判定；原始转速为 0 时立即显示 0，圆灭。
- REQ-STOR-02：无记录/旧记录转速低于 100 时显示 100，时间有效值保留。
