Gelow-serafind/Homogenizer-Proj-ES-motor/doc/原理图网络连接说明_V1.0.md

# ES 电机驱动板 引脚连接关系说明（V1.0）

> **来源与整理注（2026-09-14）**
> 本文正文为 `ES电机驱动原理图(1).pdf` 的文字识别稿（用户提供），原文中不确定处用「（待核对）」标注。
> 整理时对照图纸原件渲染与已上板验证的固件，核对结论如下：
>
> - ✅ **已核实（关键）**：`SPEED_SW`（U15 速度检测 3P 座信号脚，R25 10kΩ 上拉 +5V）**与 `USART1_RX` 为同一网络 → MCU Pin12（PB4）**。
>   与"编码器接入后串口受扰"实测现象吻合；**链路已上板验证通（2026-09-14）、计数 18/圈（2026-09-15 标定）**；固件按 PB4/EXTI4 单边沿计数。
> - ⚠️ **识别误差修正**（以图纸原件渲染 + 已上板验证固件为准）：
>   - Pin13 `PC3`=MCU_SW_B（旋钮 B 相）｜ Pin14 `PC4`=MCU_SW_PUSH（旋钮按键）｜ Pin15 `PC5`=MCU_SW_A（旋钮 A 相）
>   - Pin16 `PC6`=MCU_LCD_DATA ｜ Pin17 `PC7`=MCU_LCD_IRQ ｜ Pin18 `PD1`=MCU_LCD_WR ｜ Pin19 `PD2`=MCU_LCD_RD ｜ Pin20 `PD3`=MCU_LCD_CS
>   - Pin5 `PA1`=ADC_SCL ｜ Pin6 `PA2`=MCU_SW_SRART ｜ Pin8 `PD7`=MCU_SW_STOP
> - ⏳ 待核对项保留在原文第十二节（U15 座引脚序、+5V 来源、U1 自举/EN 细节等）。
>
> 以下为原文正文（保持原样，表格轻量格式化）。

---

⚠️ 说明：图纸分辨率有限，个别标签已用「（待核对）」标出，建议对照原图确认这几处。

## 一、电源与地网络定义

| 网络名 | 来源 | 去向 |
|---|---|---|
| VCC_24V | CN7 电源输入端子（24V，范围 4.3~60V） | 两路 Buck 输入、电机正端、Q1 集电极 |
| VCC_5V | U54（LMR16030，5V/3A 主电源）、U1（ME3116，5V/1A） | MCU、ADS1115、LCD 驱动、上拉电阻等 |
| +5V | 独立网络（图上仅见于速度检测接口区，来源待核对） | U15 速度检测接口供电 |
| GND | 公共地 | 全板 |

## 二、U9 — MCU（HK32F0301MF4P7C，20 脚）

| 引脚 | 引脚名 | 连接网络 / 器件 | 说明 |
|---|---|---|---|
| 1 | PD4 | USART1_TX | 串口发送 → H1 调试串口 |
| 2 | PD5/SWDIO/AIN0 | SWDIO | → H2 烧录口 |
| 3 | PD6/AIN1 | MCU_2MOTOR_PWM | 电机 PWM 输出 → R15(62Ω) → Q1/Q4 栅极驱动 |
| 4 | PA0/NRST | ADC_SCL（图示）/ RESET | 图示此脚标 ADC_SCL（I2C 时钟 → U37，R20 4.7kΩ 上拉）；板上另有 RESET 网络（R1 10kΩ 上拉 VCC_5V + C1 100nF 对地）。此脚为 NRST 复用脚，两网络归属请以原图核对 |
| 5 | PA1/EXTCLK1 | MCU_SW_STOP | 停止按键输入（SW7），R13 10kΩ 上拉 VCC_5V |
| 6 | PA2/WKUP3 | MCU_SW_SRART | 启动按键输入（SW1），R11 10kΩ 上拉 VCC_5V |
| 7 | VSS/VSSA | GND | C21(1uF)+C22(100nF) 为 VDD 去耦 |
| 8 | PD7/EXTCLK2 | MCU_SW_PUSH（待核对） | 编码器按下输入，R26 10kΩ 上拉 VCC_5V |
| 9 | VDD/VDDA | VCC_5V | 电源 |
| 10 | PA3 | ADC_SDA | I2C 数据 → U37 SDA（R14 4.7kΩ 上拉，待核对） |
| 11 | PB5/SWCLK/EXTCLK3 | SWCLK | → H2 烧录口 |
| 12 | PB4 | USART1_RX | ← H1 调试串口（速度信号疑似复用，见 U15 备注） |
| 13 | PC3/AIN3 | MCU_LCD_CS_5V | → U46 CS |
| 14 | PC4/AIN2/WKUP1 | MCU_LCD_DATA_5V | → U46 DATA |
| 15 | PC5/EXTCLK4 | MCU_LCD_RD_5V（待核对，图上易与 DATA 混淆） | → U46 RD |
| 16 | PC6/AIN6 | MCU_LCD_WR_5V | → U46 WR |
| 17 | PC7/WKUP2 | MCU_LCD_IRQ_5V | ← U46 IRQ |
| 18 | PD1/AIN5 | MCU_SW_A | 编码器 A 相（R27 10kΩ 上拉） |
| 19 | PD2/AIN4 | MCU_SW_B | 编码器 B 相（R28 10kΩ 上拉） |
| 20 | PD3/AIN3 | NC（待核对） | 图示未见明确标签；速度信号 SPEED_SW 疑似应接此脚 |

## 三、U37 — ADS1115IDGSR（16bit I2C ADC，PT100 温度采集）

| 引脚 | 引脚名 | 连接 |
|---|---|---|
| 1 | ADDR | GND（ADDR=0 → I2C 地址 1001000b = 0x48） |
| 2 | ALERT/RDY | ADC_RDY 网络；R17 4.7kΩ 上拉至 VCC_5V（图上未见接 MCU，轮询模式） |
| 3 | GND | GND |
| 4 | AIN0 | 经 R18(1kΩ) 接 ADC_PT1000+ |
| 5 | AIN1 | 经 R19(1kΩ) 接 ADC_PT1000+（与 AIN0 构成 PT100 差分/分压测量） |
| 6 | AIN2 | NC |
| 7 | AIN3 | NC |
| 8 | VDD | VCC_5V；C6(100nF) 对地去耦 |
| 9 | SDA | ADC_SDA → MCU PA3(10) |
| 10 | SCL | ADC_SCL → MCU PA0(4) |

CN3（HX-XH2.54-2PZZ，PT100 探头接口）：Pin1 = ADC_PT1000+；Pin2 = GND。

## 四、U54 — LMR16030PDDAR（Buck，24V→5V / 3A 主电源）

| 引脚 | 引脚名 | 连接 |
|---|---|---|
| 1 | BOOT | 经 C26(100nF) 接 Pin8 SW（自举电容） |
| 2 | VIN | VCC_24V；C39(10uF) 对地去耦 |
| 3 | EN | PW_EN 网络；经 R190(13kΩ) 上拉至 VIN |
| 4 | RT/SYNC | 接 GND（图示） |
| 5 | FB | VCC_5V 经 R189(100kΩ)；FB→GND 经 R191(17.8kΩ)；C24(100pF) 并联 R189（前馈）。Vout = 0.75×(1+100/17.8) ≈ 5V |
| 6 | SS/PGOOD | NC |
| 7 | GND | GND |
| 8 | SW | L1(4.7uH) → VCC_5V；D5(SS34) 续流至 GND |
| 9 (EP) | 散热焊盘 | GND |

输出滤波：C53(22uF) + C54(22uF)（C28 10uF 亦在输出侧）。

## 五、U1 — ME3116AM6G（Buck，5V/1A 辅助电源）

| 引脚 | 引脚名 | 连接 |
|---|---|---|
| 1 | BS | 经 C25(100pF，待核对) 接 Pin6 SW（自举） |
| 2 | GND | GND |
| 3 | FB | VCC_5V 经 R2(52.3kΩ)；FB→GND 经 R56(10kΩ)；C32(100pF) 并联 R2。Vout = 0.8×(1+52.3/10) ≈ 4.98V |
| 4 | EN | 经 R192(10kΩ) 上拉至 VIN；R43(10kΩ) 下拉 GND；C27(10uF) 对地（上电延时） |
| 5 | IN | VCC_24V；C29(1uF) 对地去耦 |
| 6 | SW | L3(6.8uH) → 5V 输出；D6(SS24) 续流至 GND |

输出滤波：C33(22uF) + C34(22uF)。

## 六、U46 — 段码 LCD 驱动器（100 脚，32kHz，HT1621 类）

| 引脚 | 引脚名 | 连接 |
|---|---|---|
| 1 | CS | MCU_LCD_CS_5V ← MCU.13 |
| 2 | RD | MCU_LCD_RD_5V ← MCU.15 |
| 3 | WR | MCU_LCD_WR_5V ← MCU.16 |
| 4 | DATA | MCU_LCD_DATA_5V ← MCU.14 |
| 5 | VSS | GND |
| 6 | OSCI | 32kHz 时钟 |
| 7 | OSCO | 32kHz 时钟（同上） |
| 8 | VDD | VCC_5V（图中经 R5(0Ω) 跳线，待核对）；C105(100nF) 对地去耦 |
| 9 | VLCD | VCC_5V 经 R182(10kΩ) —— 对比度调节 |
| 10 | IRQ | MCU_LCD_IRQ_5V → MCU.17；R183(10kΩ) 上拉 VCC_5V |
| 11 / 12 | BZ / BZ | NC（图上打 ×） |
| 13 / 14 / 15 | T1 / T2 / T3 | NC（图上打 ×） |
| 16 | COM0 | → U6.1 (COM1) |
| 17 | COM1 | → U6.2 (COM2) |
| 28~33 | COM2~COM7 | → U6.3~U6.8 (COM3~COM8) |
| 34~46 | SEG0~SEG12 | → U6.9~U6.21 (SEG0~SEG12)，一一对应 |
| 55~70 | SEG13~SEG28 | → U6.22~U6.37 (SEG13~SEG28)，一一对应 |
| 71~73 | SEG29~SEG31 | NC |
| 84~99 | SEG32~SEG47 | NC |
| 18~27 / 47~54 / 74~83 / 100 | NC | NC |

## 七、U6 — 段码 LCD 显示屏（39 脚）

- Pin1~Pin8（COM1~COM8）← U46 COM0~COM7（见上表）
- Pin9~Pin37（SEG0~SEG28）← U46 SEG0~SEG28（见上表）
- Pin38（LED−，背光负）→ GND
- Pin39（LED+，背光正，LED=3V/60mA）→ R9(33Ω) → VCC_5V（(5−3)V/33Ω ≈ 60mA ✓）

## 八、电机驱动电路（Q2 低边 PWM 斩波）

信号链：MCU_2MOTOR_PWM（MCU.3）→ R15(62Ω) → 驱动节点 N1

| 器件 | 引脚/端子 | 连接 |
|---|---|---|
| R15 62Ω | — | MCU_2MOTOR_PWM 与节点 N1 之间 |
| R7 10kΩ | — | 节点 N1 → GND（默认下拉关断） |
| Q1 MMBT5551（NPN） | 基极 | ← 节点 N1（经 R8 10Ω，待核对） |
|  | 集电极 | ← VCC_24V |
|  | 发射极 | → 栅极节点 N2 |
| Q4 MMBT5401（PNP） | 基极 | ← 节点 N1（经 R12 10Ω，待核对） |
|  | 发射极/集电极 | 与 Q1 构成对管：一端 → 栅极节点 N2，另一端 → GND（关断放电通路） |
| R6 20Ω | — | 节点 N2 → Q2 栅极（串联阻尼） |
| D2 1N4148W | — | 与 R6 并联反向（关断时栅极电荷快速泄放） |
| R10 10kΩ | — | Q2 栅极 → GND（GS 下拉保持） |
| D3 BZT52C12（12V 稳压管） | — | Q2 栅极 → 源极（GND），Vgs 钳位 12V 保护 |
| Q2 NCE6080K（N-MOS 60V） | 栅极 G | ← N2 |
|  | 源极 S | → GND |
|  | 漏极 D | → CN1 Pin2（电机负端） |

CN1（DB2EVC-3.5-2P-GN，电机接线端子）：Pin1 = VCC_24V（电机正端，常供）；Pin2 = Q2 漏极（电机负端，被 PWM 斩波调速）。

## 九、二极管

| 位号 | 型号 | 连接 |
|---|---|---|
| D1 | SS34 | 24V 输入处（CN7 附近），防反接保护（串/并联方式待核对） |
| D5 | SS34 | U54 SW(8) ↔ GND（Buck 续流） |
| D6 | SS24 | U1 SW(6) ↔ GND（Buck 续流） |

## 十、人机交互器件

SW4 — EC11E15244G1 编码旋钮（梅花柄 15mm）

| 引脚功能 | 连接 |
|---|---|
| A 相 | MCU_SW_A → MCU.18（R27 10kΩ 上拉 VCC_5V） |
| B 相 | MCU_SW_B → MCU.19（R28 10kΩ 上拉 VCC_5V） |
| C 公共端 | GND |
| 按键触点 | MCU_SW_PUSH → MCU.8（R26 10kΩ 上拉 VCC_5V） |
| 机械固定脚 | GND |

- SW1（HX-6x6x7.3 轻触键，启动）：一对触点 → MCU_SW_SRART（→ MCU.6，R11 10kΩ 上拉 VCC_5V）；另一对触点 → GND。
- SW7（同款，停止）：一对触点 → MCU_SW_STOP（→ MCU.5，R13 10kΩ 上拉 VCC_5V）；另一对 → GND。

## 十一、连接器

| 位号 | 型号 | 用途 | 引脚连接 |
|---|---|---|---|
| H1 | PZ254V-11-03P | 调试串口 | 1=USART1_TX（→MCU.1）；2=USART1_RX（→MCU.12）；3=GND |
| H2 | PZ254V-11-04P | SWD 烧录口 | VCC_5V；SWDIO（→MCU.2）；SWCLK（→MCU.11）；GND |
| CN3 | HX-XH2.54-2PZZ | PT100 温度探头 | 1=ADC_PT1000+（→R18/R19→U37）；2=GND |
| U15 | ZX-XH2.54-3PZZ | 电机光耦速度检测 | 1=SPEED_SW 信号（经 R16 1kΩ，R25 10KΩ 上拉至 +5V）；2=GND；3=+5V |
| CN7 | DB2EVC-3.5-2P-GN | 24V 电源输入 | 1=VCC_24V；2=GND |
| CN1 | DB2EVC-3.5-2P-GN | 电机输出 | 1=VCC_24V；2=Q2 漏极 |
| SCREW1~4 | — | 安装孔 | 机械固定，无电气连接 |

## 十二、要点备注（含待核对项）

- 系统架构：24V 输入 → 双路 Buck（3A 主电源 + 1A 辅助）→ 5V 系统；MCU 输出 PWM 经三极管推挽驱动 NMOS Q2，对电机做低边斩波调速；ADS1115 采集 PT100 温度；段码 LCD 显示；编码器 + 按键操作。
- I2C：MCU 与 ADS1115 为复用 I2C（ADC_SCL/ADC_SDA），从机地址 0x48（ADDR 接地）。
- 待核对项（图面分辨率所限）：
  1. MCU Pin4 的 ADC_SCL 与 RESET（R1/C1）网络归属；
  2. MCU Pin15（DATA/RD 之一）、Pin8、Pin20 的最终确认；
  3. SPEED_SW 速度信号进 MCU 的具体引脚（图上 U15 区邻近有 USART1_RX 标注，疑似与 PB4 复用）；
  4. +5V 网络（U15 供电）的来源；
  5. U1 自举电容位号（C25）、EN 上拉电阻（R192/R43）的具体接法。
