Gelow-serafind/Homogenizer-Proj-ES-motor/doc/显示屏阶段性问题排查结果.md

# 显示屏阶段性问题排查结果

> 项目：AB_motor 匀浆机（ES 电机驱动 LVD13083）
> 屏：LVD13083AVTP1 + HT1623（48SEG×8COM，1/4 偏压 1/8 占空比，96×4 位 RAM）
> 日期：2026-09-08
> 依据：Holtek HT1623 数据手册 Rev2.00（/tmp/ht1623_ds_full.pdf）、玻璃规格书第 3 页引脚表

---

## 结论摘要

| 问题 | 状态 | 根因 |
|---|---|---|
| 屏完全不亮 | ✅ 已解决 | 驱动协议错误（命令码 / RAM 组织 / 位序） |
| 只有 COM1 行亮（其余全灭） | ✅ 已解决 | U46 外接 32.768kHz 晶振不起振 → HT1623 扫描冻结在 COM0 |
| 暗态段位"半亮"残影 | ⚠️ 未解决 | VLCD 偏压偏高（R5=0Ω → VLCD=5V），待硬件调压 |
| `lcd all` 个别段位不亮 | ❓ 待确认 | 可能与对比度伪影相关，也可能为 U6 排线虚焊 |

---

## 一、屏完全不亮（已解决）

初版驱动按经验实现，有三处协议性错误：

1. **命令码错误**：误用 HT1621 记忆值（`BIAS13=0x15`、`XTAL32K=0x20`）。实测 HT1623 命令表：
   - **无 BIAS 命令**（固定 1/4 偏压、1/8 占空比）
   - 外接晶振 = `0x1C`；内部 RC 32K = `0x18`
   - 发送格式：`CS↓ + ID(100) + 9 位命令码(末位 X=0) + CS↑`
2. **RAM 组织错误**：HT1623 RAM 为 **96×4 位**（7 位地址 A6~A0，每地址 4 位数据），非"48 字节×8 位"。映射：`addr = SEG×2 + COM组(0/1)`，`位 = COM%4`
3. **位序错误**：每 nibble **D0 先发**（`...A6A0 D0D1D2D3`）

修正后屏可点亮。

## 二、只有 COM1 行亮（已解决）

现象：所有命令（`d1`/`seg0`/`raw`/`scan`）只有玻璃 COM1 行的段位（如 1a/2a/S1）显示，其余全灭；且写入内容可变化（串行口由 WR 驱动，独立于系统时钟）。

根因：初始化发送 `XTAL32K` 命令将 HT1623 时钟源切到**外接晶振 U46，而 U46 未起振** → 芯片无系统时钟 → LCD COM 扫描多路复用冻结在 COM0 相位 → 仅该相位（玻璃 COM1 行）可显示。

修复：改发 `RC32K`（内部 RC 振荡器，上电默认值），扫描恢复。

**遗留**：U46 晶振虚焊/失效未修。量产前应补焊/更换并切回 `XTAL32K`（帧频精确 64Hz）；当前用内部 RC（帧频 48~80Hz 离散）可继续开发。

## 三、暗态半亮残影（未解决）

现象：段位关闭后不完全熄灭，呈半亮；切换内容时旧段位渐暗（LCD 电荷释放，正常），但**持续半亮**为偏压问题。

分析：HT1623 为固定 1/4 偏压，VLCD 决定对比度。板上分压 `VCC5V → R5(0Ω) → VLCD → R182(10k) → GND`，VLCD=5V 满压偏高 → 暗态鉴别不足（鬼影）。原理图注释"调节对比度"，R5 即调参件。

**待办**：R5 由 0Ω 改为电阻（建议 22k~47k，VLCD≈3.4~4.1V），目标：暗态全灭、亮态清晰。可用电位器先找平衡点再固化为固定电阻。

## 四、`lcd all` 个别段位不亮（待确认）

现象（内部 RC 修复后，`lcd all` 全亮测试）：
1. Set Speed 第 2 个 8：右侧两条竖线不亮
2. Set Time 的 H 组第 2 个 8：右侧两条竖线不亮
3. 中间"----"隔断行第 1 条横线不亮

初步按段位表映射：疑似集中在 **SEG3（玻璃脚 12）** 上的 2B/2C（COM2/COM4）与 6B/6C（COM5/COM7）——但同 SEG3 的 2G/6G（COM3/COM6）疑似正常，模式不干净，**尚不能定性**。

**两种可能**：
- A. 对比度伪影（见三）——偏压临界导致部分该亮段位未达阈值，调好 VLCD 后可能消失
- B. U6 排线/驱动芯片某几根引线虚焊（U46 晶振同为虚焊，怀疑排线存在系统性焊接问题）

**待办（顺序）**：
1. 先调 R5 修正对比度 → 重跑 `lcd all` 复测
2. 仍不亮则用 `lcd d2` / `lcd seg3` 精确核对，确认死段坐标
3. 确认后检查 HT1623 芯片（LQFP100，重点 COM/SEG 相关引脚）与 U6 FPC 排线焊点，补焊复查

---

## 段位语义表（2026-10-08 按规格书纠正旧校准记录）

> 方法：shell `lcd sweep`（S1→S30 自动轮扫 1.5s/个，串口同步编号），上板目视记录。
> 纠正：旧记录 S1/S2 对调，S3 误认运行箭头；“30/30 全匹配”结论撤回。当前表依据规格书第 3 页，待上板复核。
> 用途：`display.c` 的 `iconBind` / `dispAlwaysOn` / `DISP_TEMP_*` 均已按本表填充。

| S 编号 | 语义 | 渲染策略 |
|---|---|---|
| S1 | **Set Speed 标签** | 常显，含暂停 |
| S2 | **时钟** | RUNNING 且倒计时 active 时亮，零时间/暂停/待机灭 |
| S3 | **警告三角感叹号** | 本版恒灭；无独立运行箭头 |
| S4 | 圆（旋转圈圈） | 图标：RUNNING 且实测转速 > 0；暂停/待机立即灭 |
| S5 | "Rpm"（上半） | 常显 |
| S6 | "Set Time" 标签 | 常显 |
| S7 / S8 / S9 | "H" / "m" / "s"（上半） | 常显 |
| S10~S19 | **中间十条横线（隔断线）** | 常显（占 10 段） |
| S20 | "Instant Speed" 标签 | 常显 |
| S21 | "Rpm"（下半） | 常显 |
| S22 | "Remaining Time" 标签 | 常显 |
| S23 / S24 / S25 | "H" / "m" / "s"（下半） | 常显 |
| S26 | "Instant"（温度标签前半，与 S27 拆两段） | 随探头在位（REQ-DISP-06） |
| S27 | "Temp"（温度标签后半） | 随探头在位 |
| S28 | 温度小数点 "." | 0.1℃ 格式点亮 |
| S29 | "℃" | 随温度显示 |
| S30 | **十字架** | 图标：PT1000 在位 |

- 页面布局：上下两部分由 S10~S19 十条横线分隔；上半 = Set Speed(Rpm) + Set Time(H/m/s)，下半 = Instant Speed(Rpm) + Instant Temp + Remaining Time(H/m/s)。
- 规格图明确存在感叹号 S3；原“玻璃无此段”的结论错误。S1/S2/S3 已纠正，其他段位表保持。

### 数码位（digit）字段布局（2026-09-16 实测最终确认）

> 确认方式：设 Set Time=2h24m33s、温度占位 25.8，四路交叉验证——
> "2h" 正确 → Remaining H=17-20；"24/33" 落入 [25-28]（拼成 243.3）→ 温度=25-28；
> "25.8" 落入 [21-24] 显示为 "2m 58s" → m/s=21-24。

| 字段 | 数码位 | 备注 |
|---|---|---|
| Set Speed | 1-4 | 此前测试验证正确 |
| Set Time | 5-12 | H4:M2:S2 连续 |
| Instant Speed | 13-16 | 此前测试验证正确 |
| **Remaining Time** | **17-24** | H4:M2:S2 连续（原推断 21-28 错位） |
| **Instant Temp** | **25-28** | 修正（原推断 17-20 错位） |

---

## 环境与命令备忘

- 显示调试命令（shell）：`lcd all` / `lcd off` / `lcd d1-28`（数码位显 8） / `lcd s1-30`（图标） / `lcd seg0-28`（整条 SEG 8 段） / `lcd raw <addr0-95> <val0-15>`（单 nibble） / `lcd scan`（自动扫地址 0-7） / **`lcd sweep`（S1-S30 自动轮扫，1.5s/个，串口同步编号——图标/单位/小数点语义校准用）**
- 注意：`seg`/`scan` 分支须排在 `s` 图标分支之前（前缀冲突，已修正）
- HT1623_Delay 已放大至 ~8µs/半周期，帧间 CS 高电平保持 ≥ 3×Delay（>700ns 规格）
- 残影（切换后约 0.1~0.3s 渐暗）= LCD 段位正常电荷释放，非故障，可忽略
