Gelow-serafind/Homogenizer-Proj-ES-motor/Documents/4_API/HK32F0301MxxxxC_API_Update_Version.txt

/*
* @file name: HK32F0301MxxxxC_API_Update_Version
* @description: 本文件是用来描述HK32F0301MxxxxC系列芯片API文档版本列表
* @author: AE Team
*/

V1.0.0/2025-07-17
1. 首次发布
