Gelow-serafind/Homogenizer-Proj-ES-motor/Documents/5_Hardware/crop_mcu.png

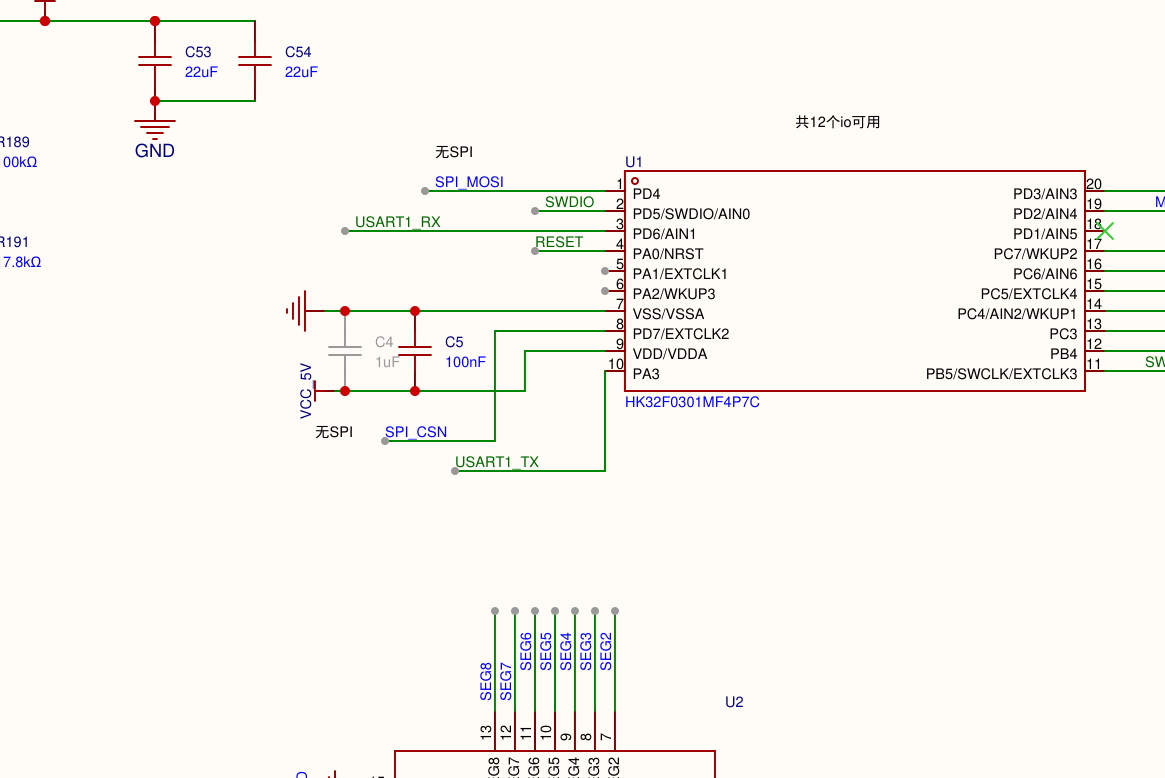
Documents/5_Hardware/crop_mcu.png
