Gelow-serafind/Homogenizer-Proj-ES-motor/Documents/5_Hardware/crop_mcu_full.png

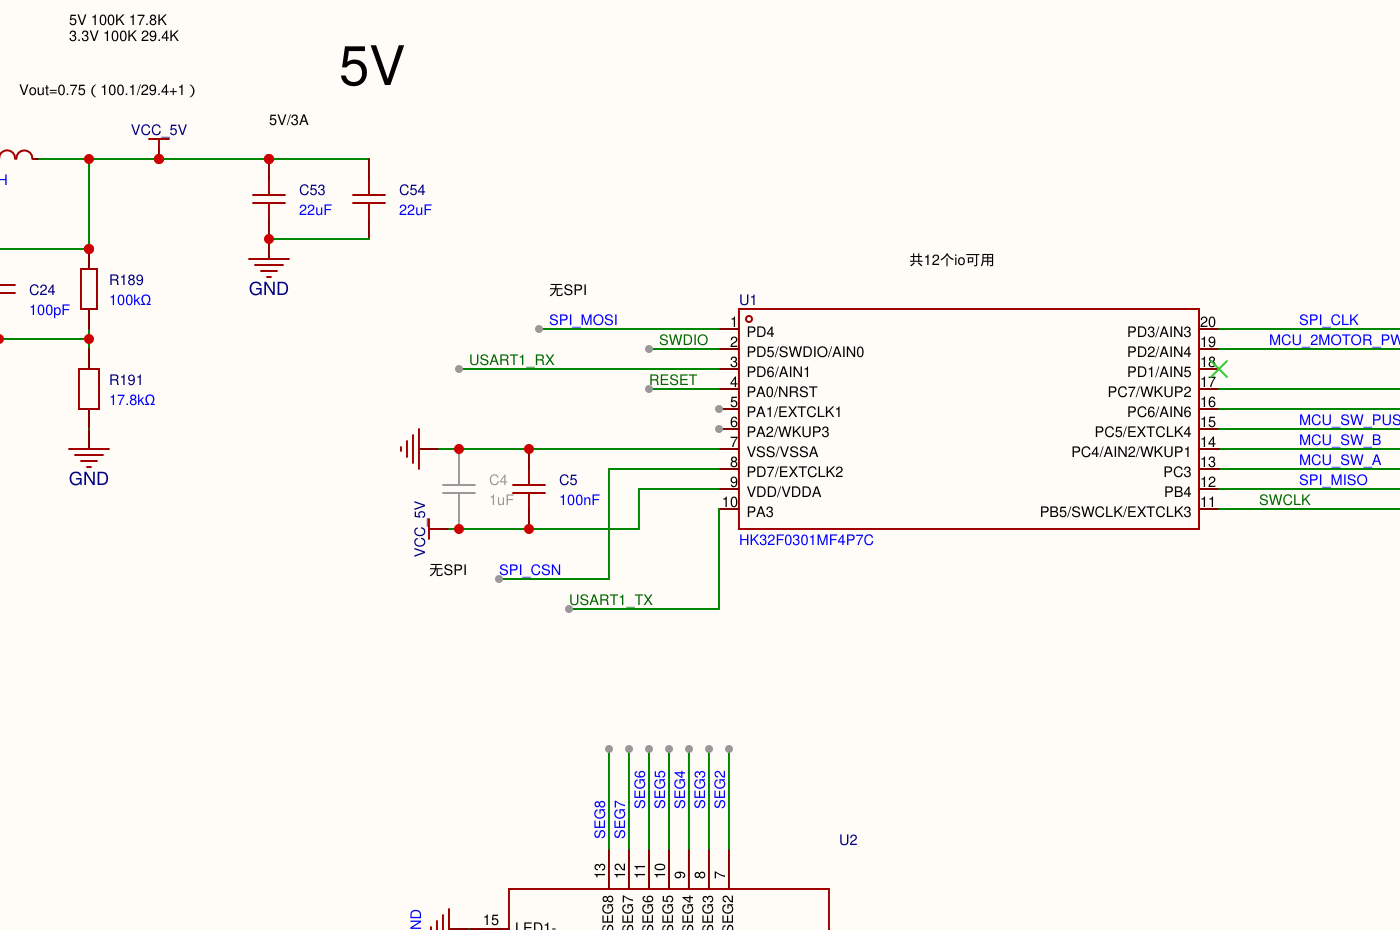
Documents/5_Hardware/crop_mcu_full.png
