Gelow-serafind/Homogenizer-Proj-ES-motor/Documents/5_Hardware/crop_mcu_right.png

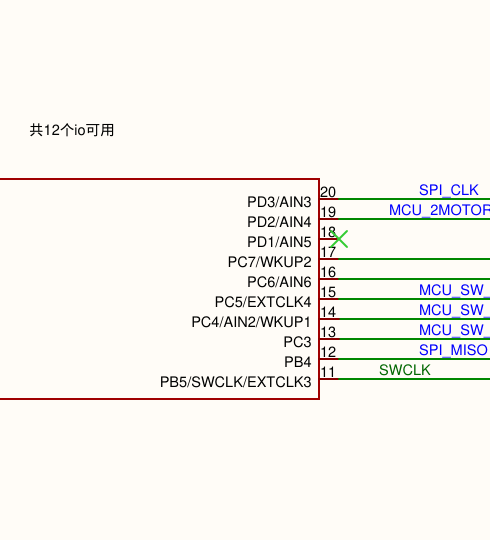
Documents/5_Hardware/crop_mcu_right.png
