Gelow-serafind/Homogenizer-Proj-ES-motor/Documents/5_Hardware/crop_motor2.png

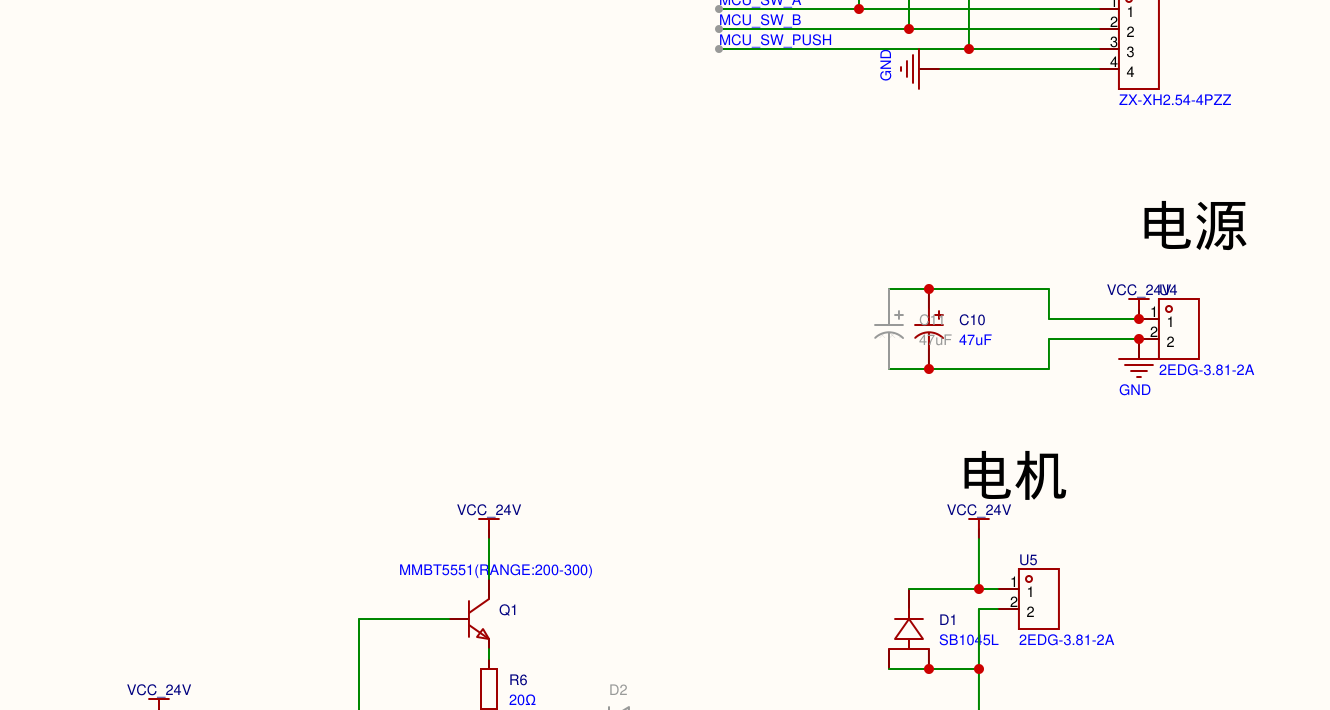
Documents/5_Hardware/crop_motor2.png
