Gelow-serafind/Homogenizer-Proj-ES-motor/Documents/5_Hardware/grid_0_1.png

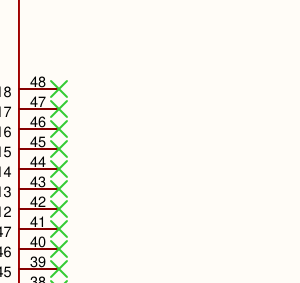
Documents/5_Hardware/grid_0_1.png
