Gelow-serafind/Homogenizer-Proj-ES-motor/Documents/5_Hardware/grid_0_2.png

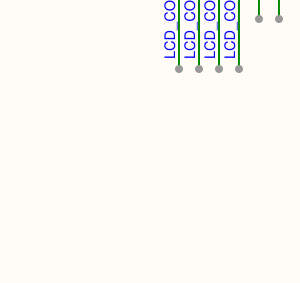
Documents/5_Hardware/grid_0_2.png
