Gelow-serafind/Homogenizer-Proj-ES-motor/Documents/5_Hardware/grid_1_0.png

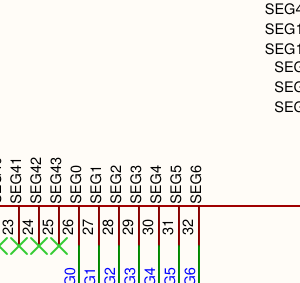
Documents/5_Hardware/grid_1_0.png
