Gelow-serafind/Homogenizer-Proj-ES-motor/Documents/5_Hardware/grid_2_2.png

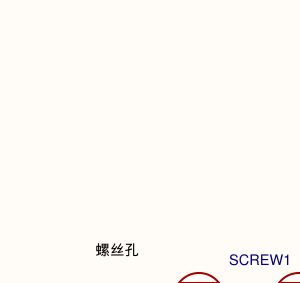
Documents/5_Hardware/grid_2_2.png
