Gelow-serafind/Homogenizer-Proj-ES-motor/Documents/5_Hardware/page_1.png

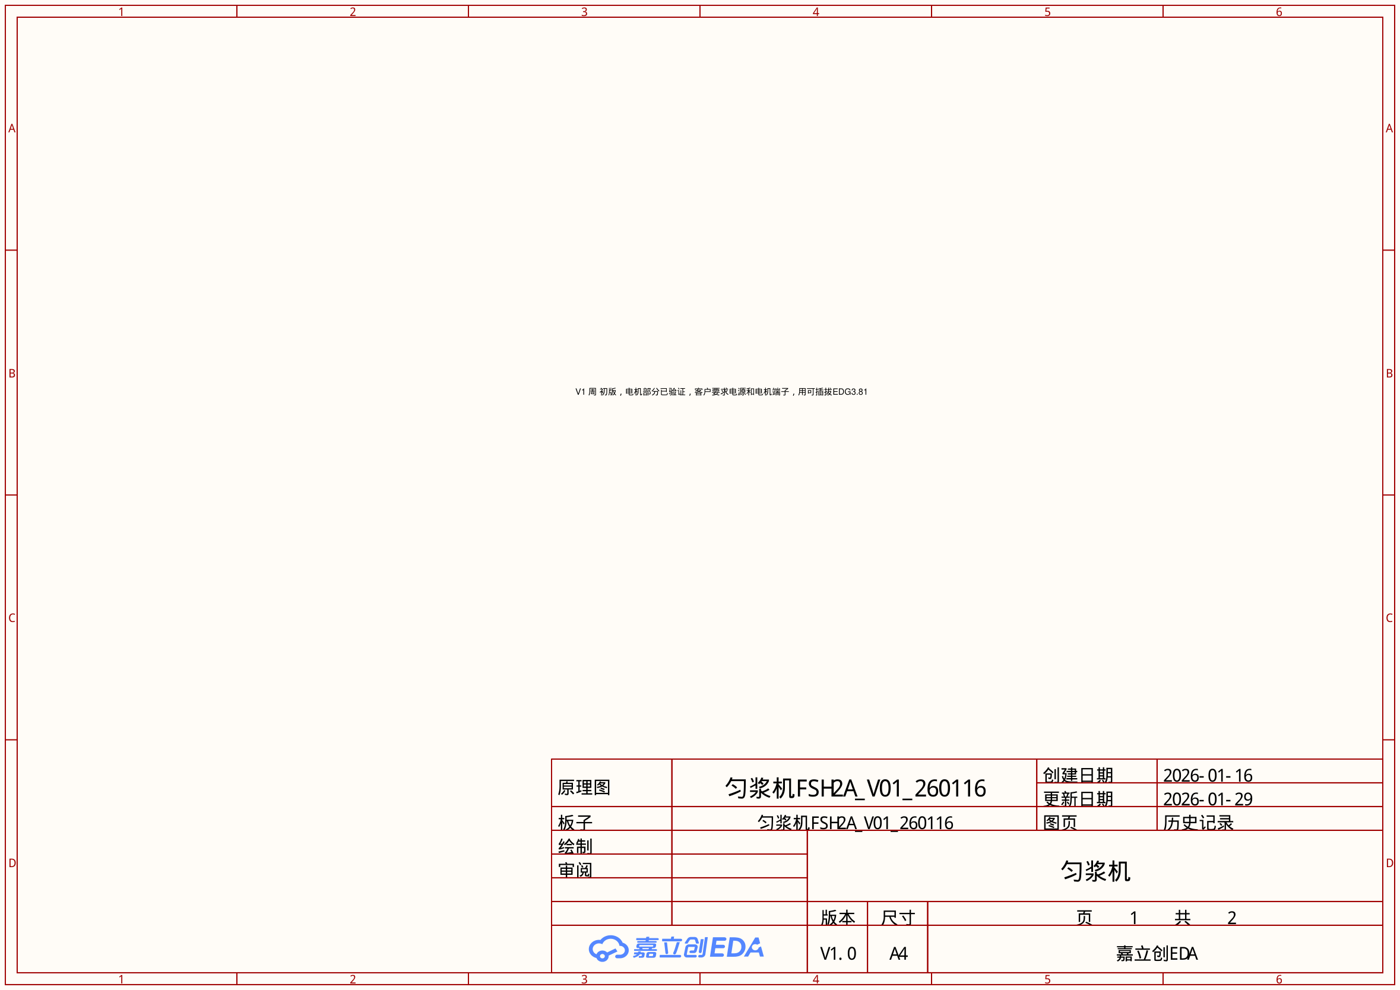
Documents/5_Hardware/page_1.png
