Gelow-serafind/Homogenizer-Proj-ES-motor/Proj/MDK-ARM/README_ARMCOMPILER6_FIX.md

# ARM Compiler 6 (ARMCLANG) 兼容性修复

## 问题描述
使用 ARM Compiler 6 (ARMCLANG) 编译 HK32 SDK 时出现以下错误：
```
error: call to undeclared function 'asm'; ISO C99 and later do not support implicit function declarations [-Wimplicit-function-declaration]
  NOP();
  ^
```

## 问题原因
HK32 SDK 的 `hk32f0301mxxc_def.h` 文件中，`NOP()` 宏定义为：
```c
#if defined ( __CC_ARM )
#define NOP()   __nop()
#else
#define NOP()   asm("nop")
#endif
```

ARM Compiler 6 不定义 `__CC_ARM` 宏，而是定义 `__ARMCC_VERSION` 宏。因此代码进入了 `#else` 分支，使用了 `asm("nop")` 语法，这在 ARM Compiler 6 中不被支持。

## 修复方法

### 方法一：手动修改文件（推荐）

打开文件：
```
../../../../Libraries/HK32F0301MxxC_StdPeriph_Driver/inc/hk32f0301mxxc_def.h
```

修改第 99 行：
```c
// 原代码：
#if defined ( __CC_ARM   ) || defined   (  __GNUC__  )

// 修改为：
#if defined ( __CC_ARM   ) || defined   (  __GNUC__  ) || \
    (defined(__ARMCC_VERSION) && (__ARMCC_VERSION >= 6000000))
```

修改第 113-117 行：
```c
// 原代码：
#if defined ( __CC_ARM   )
#define NOP()   __nop()
#else
#define NOP()   asm("nop")
#endif

// 修改为：
#if defined ( __CC_ARM   ) || \
    (defined(__ARMCC_VERSION) && (__ARMCC_VERSION >= 6000000))
/* ARM Compiler 5/6 */
#define NOP()   __nop()
#else
/* GCC/IAR Compiler */
#define NOP()   asm("nop")
#endif
```

### 方法二：使用修复脚本

在终端中运行：
```bash
# 给脚本执行权限
chmod +x apply_armcompiler6_fix.sh

# 运行修复脚本
./apply_armcompiler6_fix.sh
```

### 方法三：使用 patch 命令

```bash
# 应用补丁
patch -p4 < hk32_armc6_fix.diff
```

## 修复后的代码

修复后，`NOP()` 宏会正确判断 ARM Compiler 6 并使用 `__nop()` 内置函数。

## 验证修复

1. 重新编译项目
2. 应该不再出现 `call to undeclared function 'asm'` 错误

## 恢复原始文件

如果需要恢复原始文件：
```bash
cp "../../../../Libraries/HK32F0301MxxC_StdPeriph_Driver/inc/hk32f0301mxxc_def.h.backup" \
   "../../../../Libraries/HK32F0301MxxC_StdPeriph_Driver/inc/hk32f0301mxxc_def.h"
```

## 注意事项
1. 此修复只解决 `NOP()` 宏的编译问题
2. ARM Compiler 6 可能需要其他兼容性调整
3. 建议测试所有功能以确保完全兼容
