Gelow-serafind/Homogenizer-Proj-ES-motor/Documents/5_Hardware/crop_debug_area.png

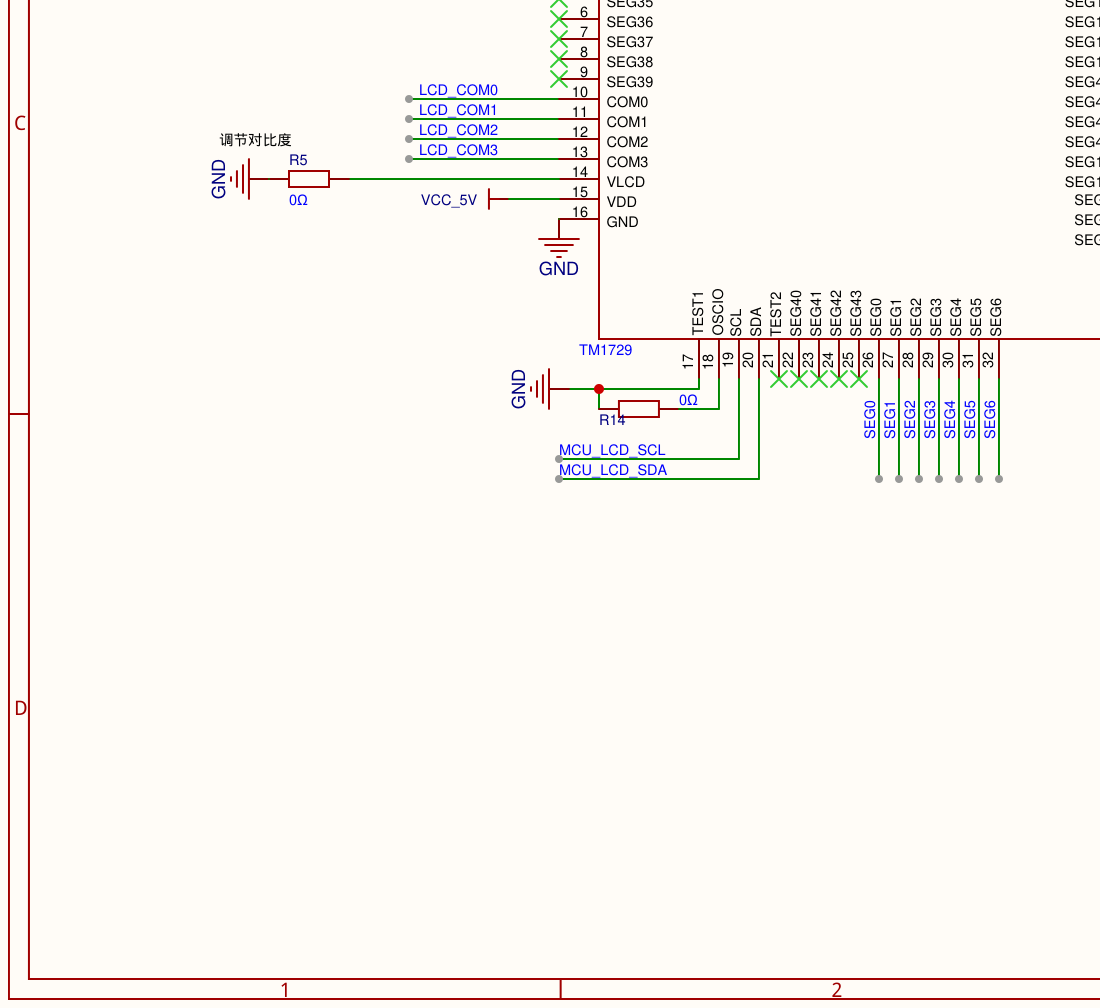
Documents/5_Hardware/crop_debug_area.png
