Gelow-serafind/Homogenizer-Proj-ES-motor/Documents/5_Hardware/debug1.png

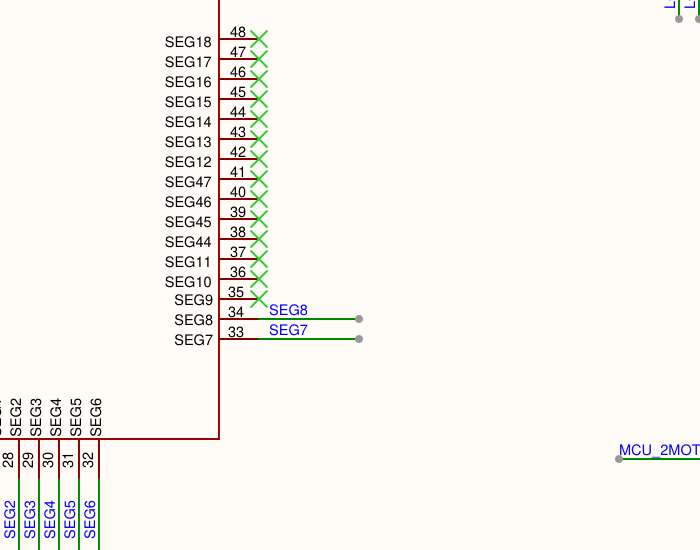
Documents/5_Hardware/debug1.png
