Gelow-serafind/Homogenizer-Proj-ES-motor/Documents/5_Hardware/debug2.png

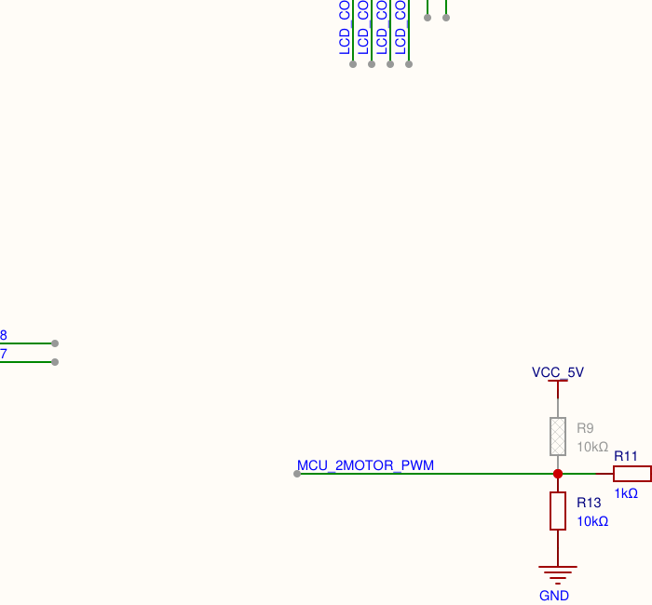
Documents/5_Hardware/debug2.png
