Gelow-serafind/Homogenizer-Proj-ES-motor/Documents/5_Hardware/debug3.png

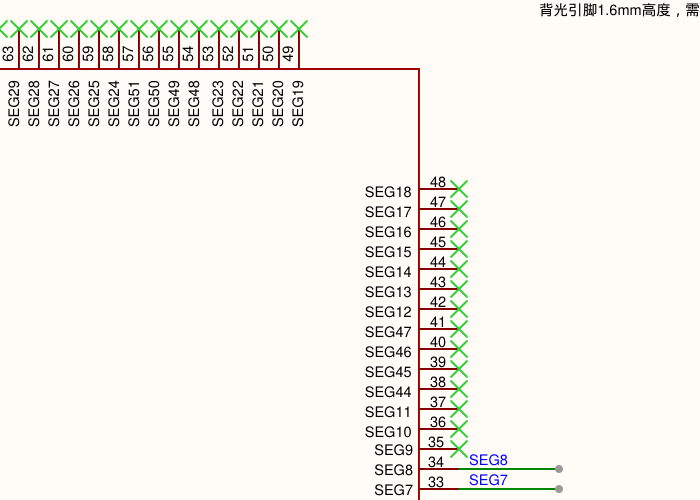
Documents/5_Hardware/debug3.png
