Gelow-serafind/Homogenizer-Proj-ES-motor/Documents/5_Hardware/debug4.png

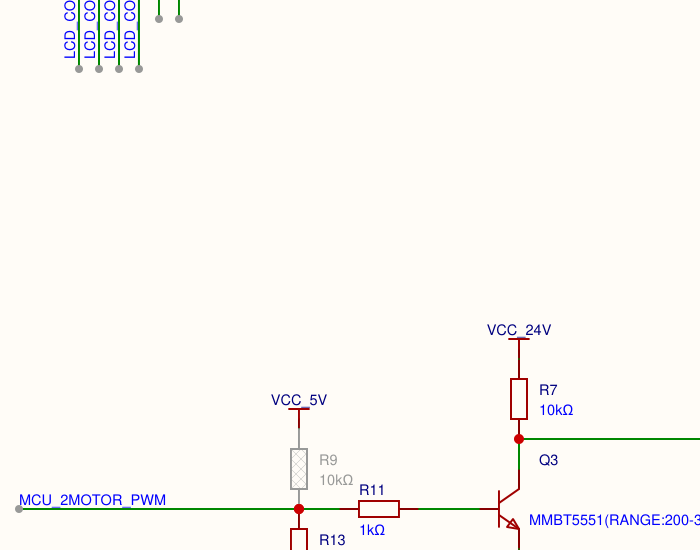
Documents/5_Hardware/debug4.png
