Gelow-serafind/Homogenizer-Proj-ES-motor/Documents/5_Hardware/debug_block.png

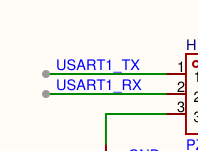
Documents/5_Hardware/debug_block.png
