Gelow-serafind/Homogenizer-Proj-ES-motor/Documents/5_Hardware/debug_h1_area.png

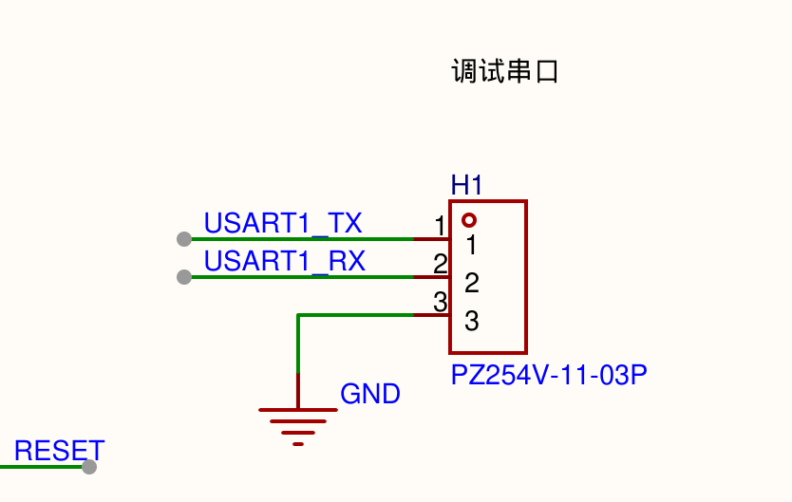
Documents/5_Hardware/debug_h1_area.png
