Gelow-serafind/Homogenizer-Proj-ES-motor/Documents/5_Hardware/SCH_匀浆机FSH2A_V01_260116_2026-04-04.pdf

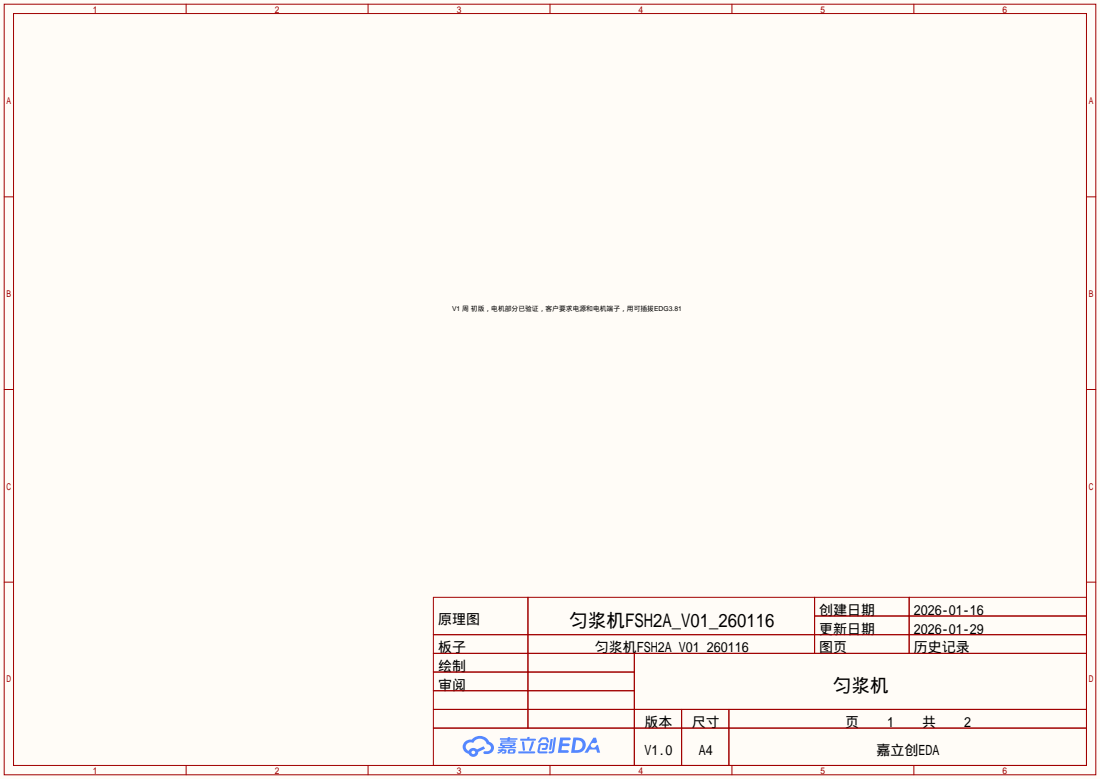
[picture p27: page 1]

原理图 | 匀浆机FSH2A_V01_260116 | 创建日期 | 2026-01-16

更新日期 | 2026-01-29

板子 | 匀浆机FSH2A_V01_260116 | 图页 | 历史记录
绘制 | | 匀浆机
审阅

V1.0 | A4 | 嘉立创EDA

# FBSEG¹ SEG²

5V

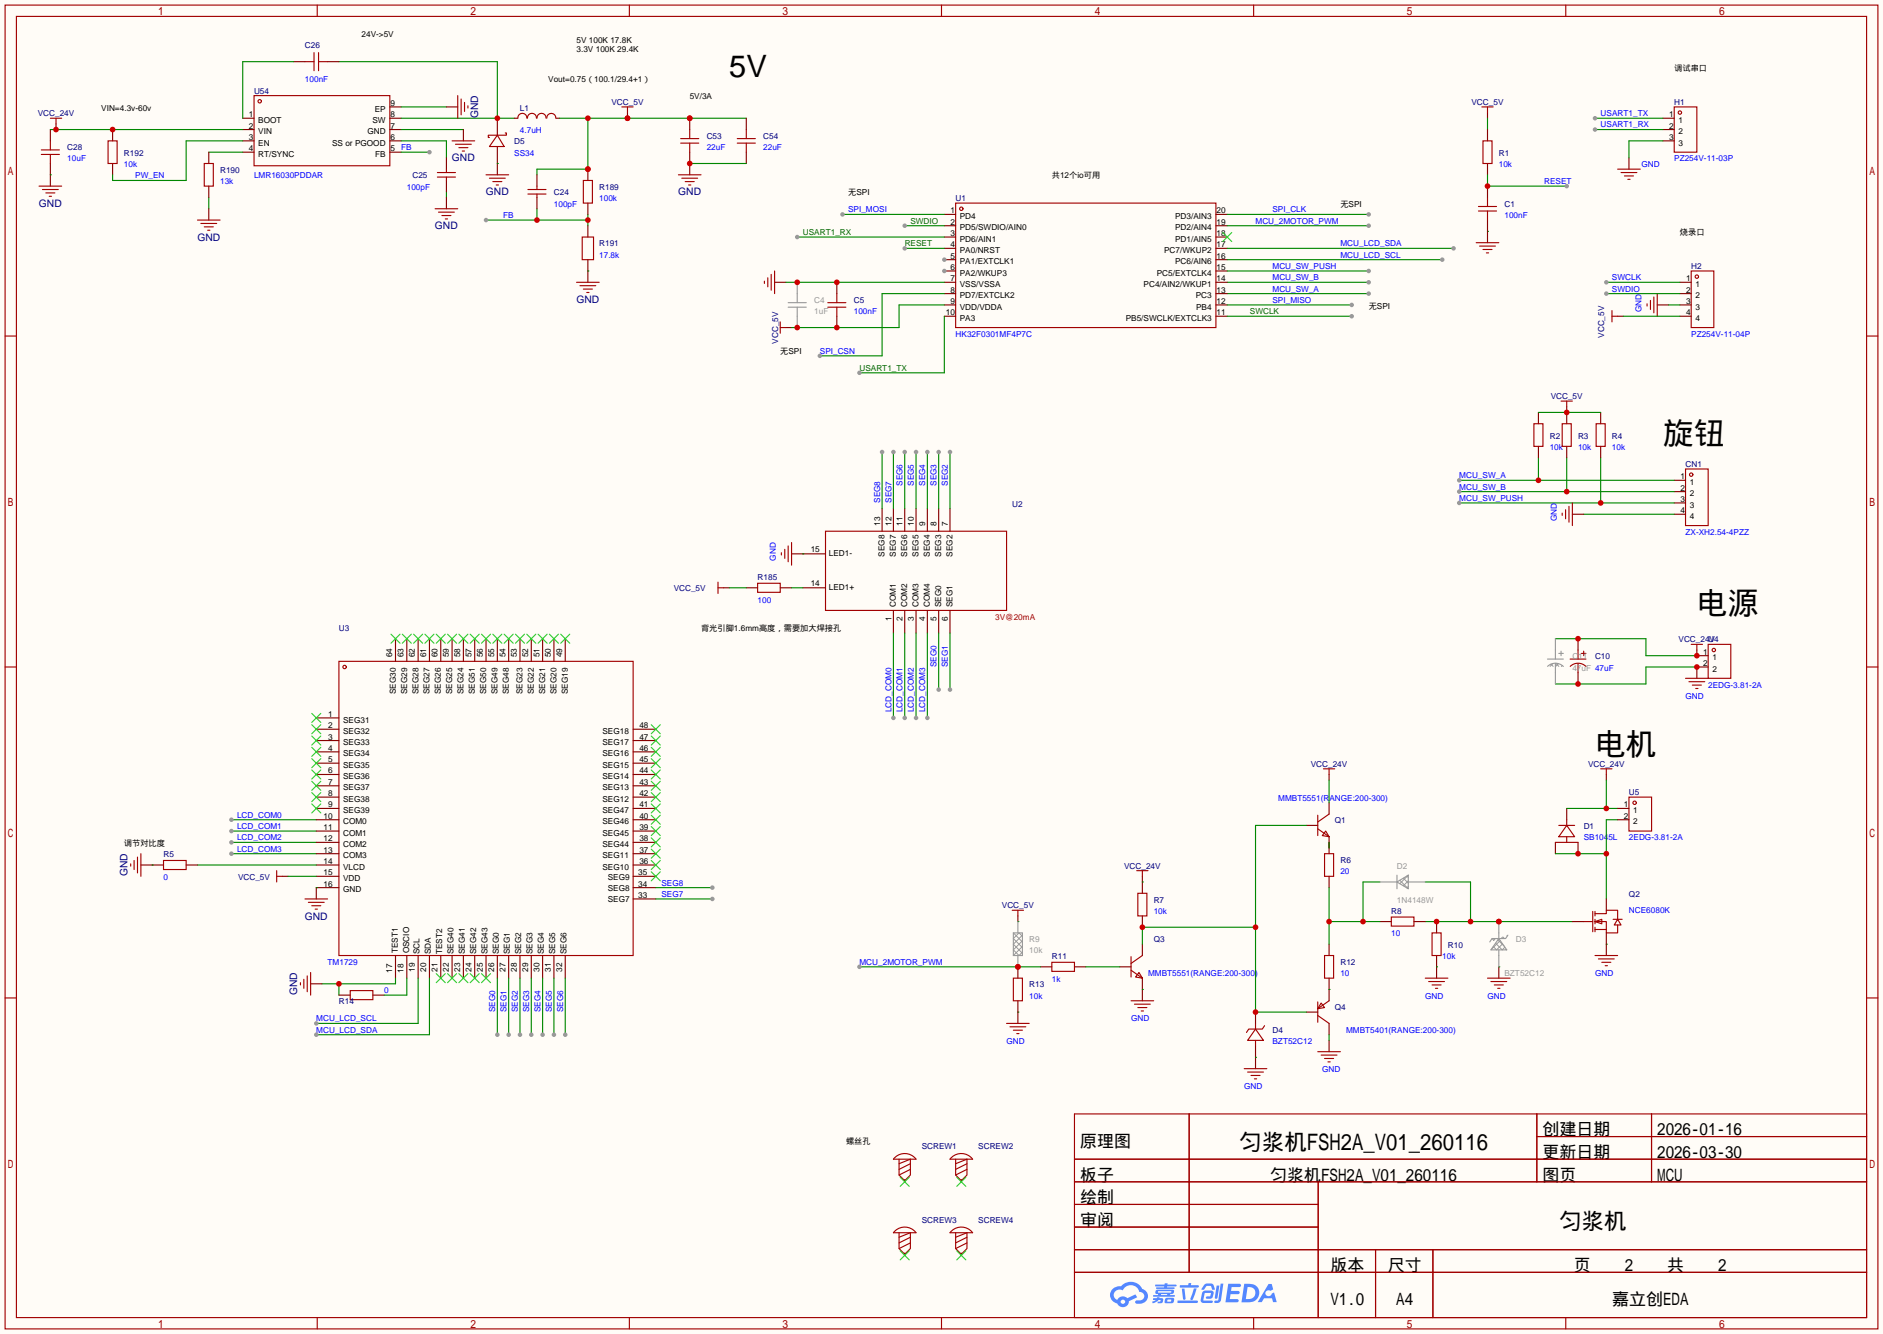
[picture p28: page 2]

原理图 | 匀浆机FSH2A_V01_260116 | 创建日期 | 2026-01-16

更新日期 | 2026-03-30

板子 | 匀浆机FSH2A_V01_260116 | 图页 | MCU
绘制 | | 匀浆机
审阅

V1.0 | A4 | 嘉立创EDA
