Gelow-serafind/Homogenizer-Proj-ES-motor/doc/ES电机驱动原理图(1).pdf

# MCU

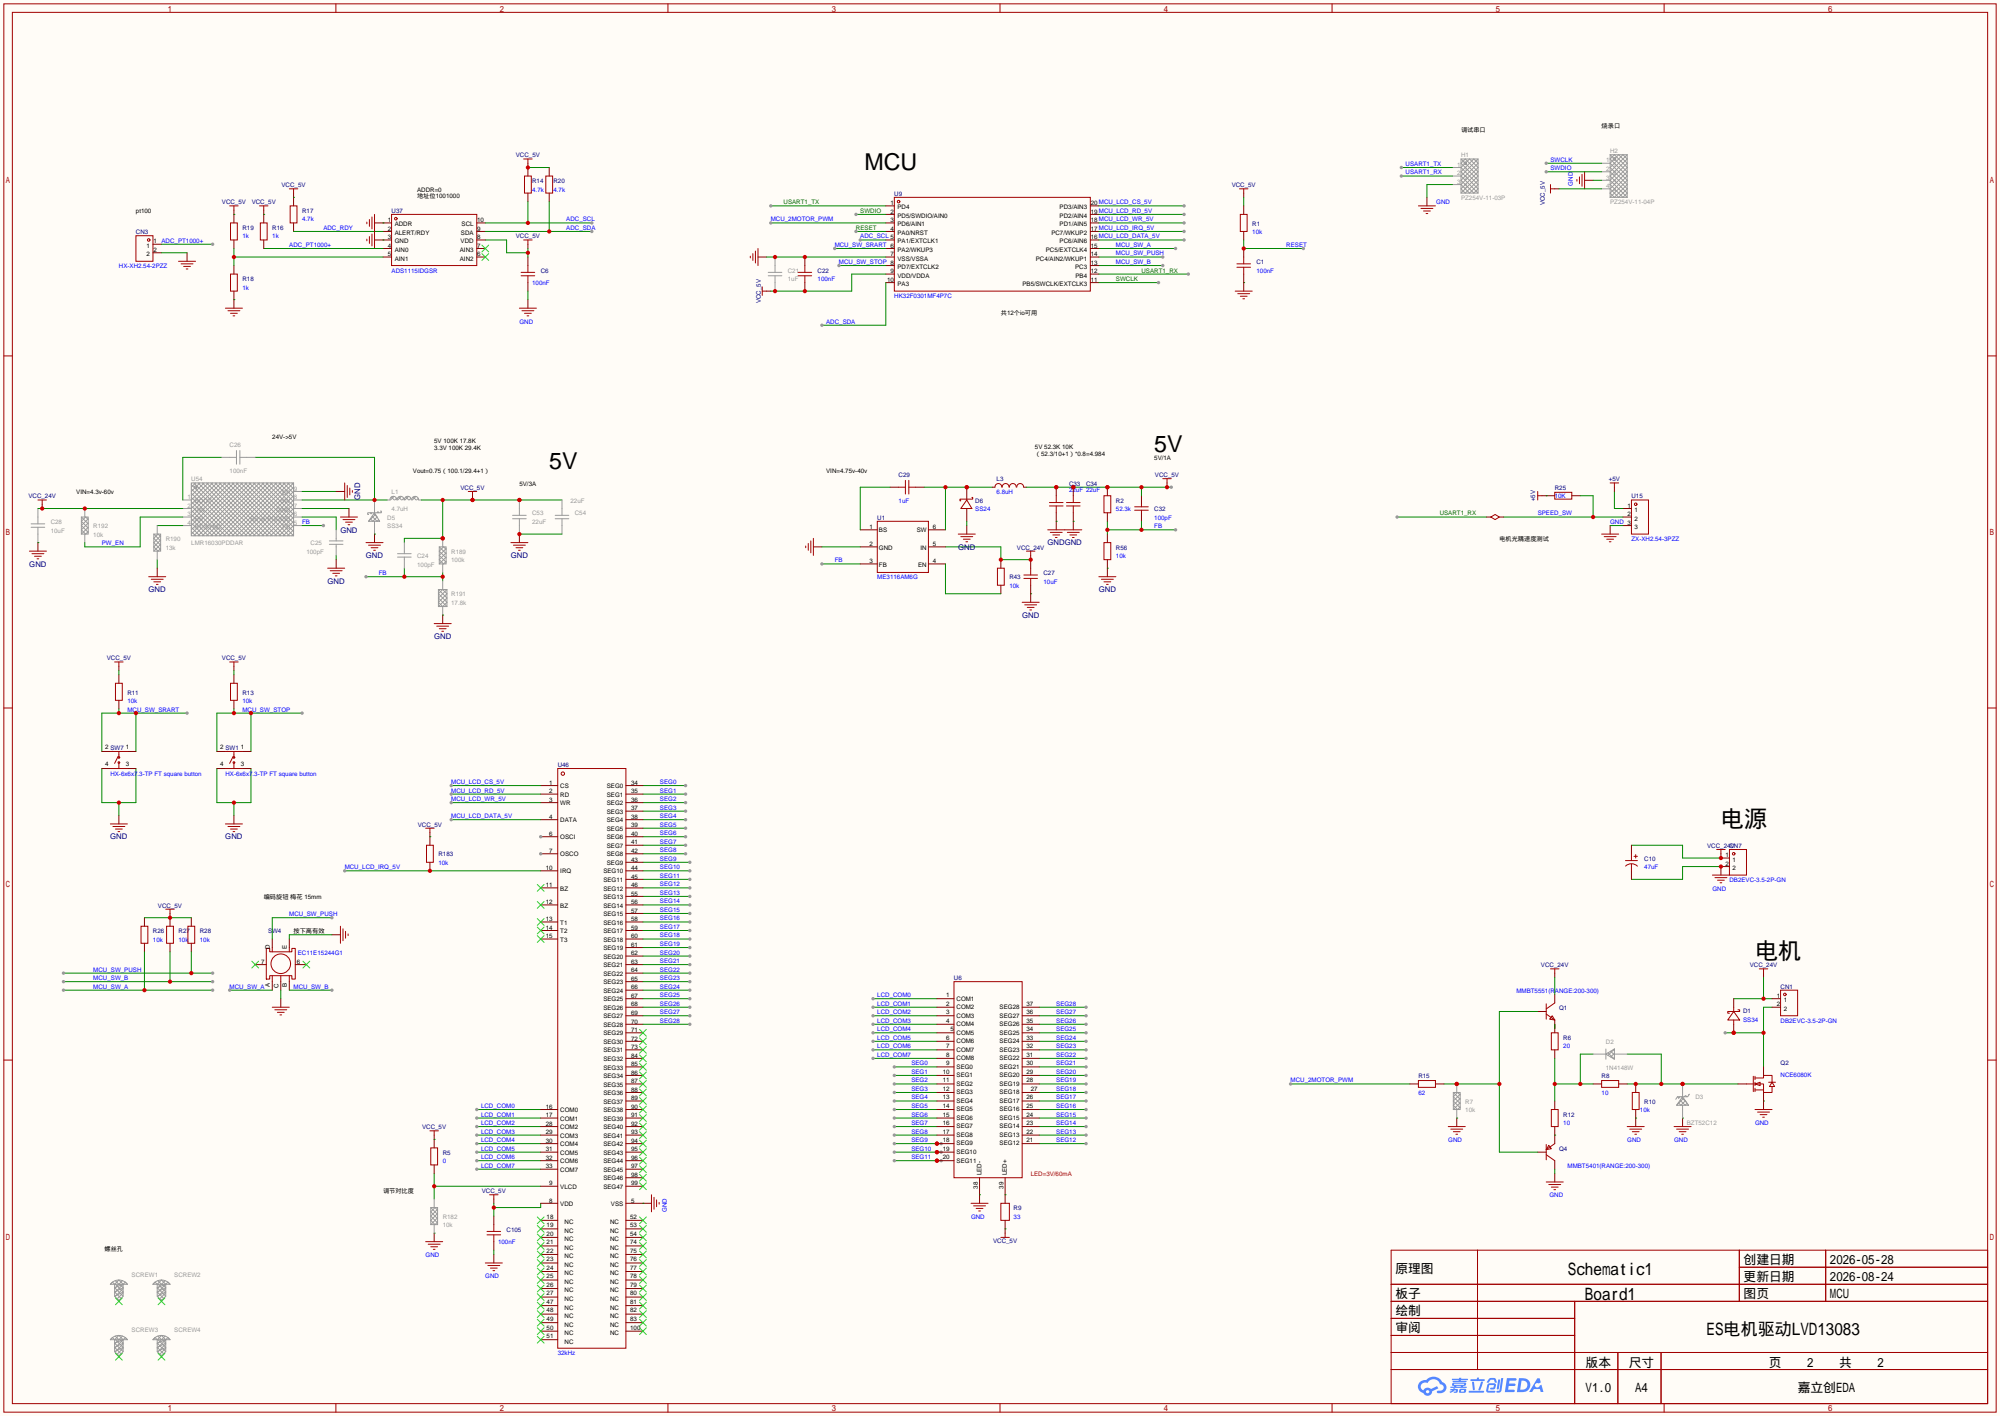
[picture p29: page 1]

HX-6x6x7.3-TP FT square button

原理图 | Schematic1 | 创建日期 | 2026-05-28

更新日期 | 2026-08-24

板子 | Board1 | 图页 | MCU
绘制 | | ES电机驱动LVD13083
审阅

V1.0 | A4 | 嘉立创EDA
