Gelow-serafind/Homogenizer-Proj-ES-motor/Boards/Board_HK32F0301MF4P7C_EVAL/src/hk32f0301mf4p7c_eval.c

/**
  ******************************************************************************
  * @file    hk32f0301mf4p7c_eval.c
  * @author  Alexander
  * @version V1.0.0
  * @date    30-Jan-2023
  * @brief   This file provides firmware functions to manage Leds, push-buttons, 
  *          COM portsavailable on HK32F0301MF4P7C-EVAL evaluation board from HKMicro
  *          -electronics.     
  ******************************************************************************
  */
  
/* Includes ------------------------------------------------------------------*/
#include "hk32f0301mf4p7c_eval.h"

/** @addtogroup Boards
  * @{
  */ 

/** @addtogroup HK32_EVAL
  * @{
  */ 

/** @addtogroup HK32F0301MF4P7C_EVAL
  * @{
  */   
    
/** @defgroup HK32F0301MF4P7C_EVAL_LOW_LEVEL 
  * @brief This file provides firmware functions to manage Leds, push-buttons, 
  *        COM ports on HK32F0301MF4P7C-EVAL evaluation board from HKMicroelectronics.
  * @{
  */ 

/* Private typedef -----------------------------------------------------------*/
/* Private define ------------------------------------------------------------*/
/* Private macro -------------------------------------------------------------*/
/* Private variables ---------------------------------------------------------*/
GPIO_TypeDef* GPIO_PORT[LEDn] = {LED1_GPIO_PORT, LED2_GPIO_PORT,LED3_GPIO_PORT};
const uint16_t GPIO_PIN[LEDn] = {LED1_PIN, LED2_PIN,LED3_PIN};
const uint32_t GPIO_CLK[LEDn] = {LED1_GPIO_CLK, LED2_GPIO_CLK,LED3_GPIO_CLK};

GPIO_TypeDef* BUTTON_PORT[BUTTONn] = {BUTTON_1_GPIO_PORT, BUTTON_2_GPIO_PORT}; 

const uint16_t BUTTON_PIN[BUTTONn] = {BUTTON_1_PIN, BUTTON_2_PIN}; 

const uint32_t BUTTON_CLK[BUTTONn] = {BUTTON_1_GPIO_CLK, BUTTON_2_GPIO_CLK};

const uint16_t BUTTON_EXTI_LINE[BUTTONn] = {BUTTON_1_EXTI_LINE,
                                            BUTTON_2_EXTI_LINE};

const uint16_t BUTTON_PORT_SOURCE[BUTTONn] = {BUTTON_1_EXTI_PORT_SOURCE,
                                              BUTTON_2_EXTI_PORT_SOURCE};
                 
const uint16_t BUTTON_PIN_SOURCE[BUTTONn] = {BUTTON_1_EXTI_PIN_SOURCE,
                                             BUTTON_2_EXTI_PIN_SOURCE}; 

const uint16_t BUTTON_IRQn[BUTTONn] = {BUTTON_1_EXTI_IRQn, BUTTON_2_EXTI_IRQn};


UART_TypeDef* COM_UART[COMn] = {EVAL_COM1}; 

GPIO_TypeDef* COM_TX_PORT[COMn] = {EVAL_COM1_TX_GPIO_PORT};
 
GPIO_TypeDef* COM_RX_PORT[COMn] = {EVAL_COM1_RX_GPIO_PORT};

const uint32_t COM_USART_CLK[COMn] = {EVAL_COM1_CLK};

const uint32_t COM_TX_PORT_CLK[COMn] = {EVAL_COM1_TX_GPIO_CLK};
 
const uint32_t COM_RX_PORT_CLK[COMn] = {EVAL_COM1_RX_GPIO_CLK};

const uint16_t COM_TX_PIN[COMn] = {EVAL_COM1_TX_PIN};

const uint16_t COM_RX_PIN[COMn] = {EVAL_COM1_RX_PIN};
 
const uint16_t COM_TX_PIN_SOURCE[COMn] = {EVAL_COM1_TX_SOURCE};

const uint16_t COM_RX_PIN_SOURCE[COMn] = {EVAL_COM1_RX_SOURCE};
 
const uint16_t COM_TX_AF[COMn] = {EVAL_COM1_TX_AF};
 
const uint16_t COM_RX_AF[COMn] = {EVAL_COM1_RX_AF};
/* Private function prototypes -----------------------------------------------*/
/* Private functions ---------------------------------------------------------*/ 

/** @defgroup HK32F0301MF4P7C_EVAL_LOW_LEVEL_Private_Functions
  * @{
  */ 

/**
  * @brief  Configures LED GPIO.
  * @param  Led: Specifies the Led to be configured. 
  *          This parameter can be one of following parameters:
  *            @arg LED1
  *            @arg LED2
  *            @arg LED3
  * @retval None
  */
void HK_EVAL_LEDInit(Led_TypeDef Led)
{
  GPIO_InitTypeDef  GPIO_InitStructure;
  
  /* Enable the GPIO_LED Clock */
  RCC_AHBPeriphClockCmd(GPIO_CLK[Led], ENABLE);

  /* Configure the GPIO_LED pin */
  GPIO_InitStructure.GPIO_Pin = GPIO_PIN[Led];
  GPIO_InitStructure.GPIO_Mode = GPIO_Mode_OUT;
  GPIO_InitStructure.GPIO_OType = GPIO_OType_PP;
  GPIO_InitStructure.GPIO_PuPd = GPIO_PuPd_NOPULL;
  GPIO_InitStructure.GPIO_Speed = GPIO_Speed_10MHz;
  GPIO_Init(GPIO_PORT[Led], &GPIO_InitStructure);
  GPIO_PORT[Led]->BSRR = GPIO_PIN[Led];
}

/**
  * @brief  Turns selected LED On.
  * @param  Led: Specifies the Led to be set on. 
  *          This parameter can be one of following parameters:
  *            @arg LED1
  *            @arg LED2
  *            @arg LED3
  * @retval None
  */
void HK_EVAL_LEDOn(Led_TypeDef Led)
{
  GPIO_PORT[Led]->BRR = GPIO_PIN[Led];
}

/**
  * @brief  Turns selected LED Off.
  * @param  Led: Specifies the Led to be set off. 
  *          This parameter can be one of following parameters:
  *            @arg LED1
  *            @arg LED2
  *            @arg LED3
  * @retval None
  */
void HK_EVAL_LEDOff(Led_TypeDef Led)
{
  GPIO_PORT[Led]->BSRR = GPIO_PIN[Led];
}

/**
  * @brief  Toggles the selected LED.
  * @param  Led: Specifies the Led to be toggled. 
  *          This parameter can be one of following parameters:
  *            @arg LED1
  *            @arg LED2
  *            @arg LED3
  * @retval None
  */
void HK_EVAL_LEDToggle(Led_TypeDef Led)
{
  GPIO_PORT[Led]->ODR ^= GPIO_PIN[Led];
}

/**
  * @brief  Configures Button GPIO and EXTI Line.
  * @param  Button: Specifies the Button to be configured.
  *          This parameter can be one of following parameters:
  *            @arg BUTTON_1: Button1 Push Button
  *            @arg BUTTON_2: Button2 Push Button     
  * @param  Button_Mode: Specifies Button mode.
  *          This parameter can be one of following parameters:   
  *            @arg BUTTON_MODE_GPIO: Button will be used as simple IO 
  *            @arg BUTTON_MODE_EXTI: Button will be connected to EXTI line with interrupt
  *                     generation capability
  * @retval None
  */
void HK_EVAL_PBInit(Button_TypeDef Button, ButtonMode_TypeDef Button_Mode)
{
  GPIO_InitTypeDef GPIO_InitStructure;
  EXTI_InitTypeDef EXTI_InitStructure;
  NVIC_InitTypeDef NVIC_InitStructure;

  /* Enable the BUTTON Clock */
  RCC_AHBPeriphClockCmd(BUTTON_CLK[Button], ENABLE);
  RCC_APBPeriph2ClockCmd(RCC_APBPeriph2_SYSCFG, ENABLE);

  /* Configure Button pin as input */
  GPIO_InitStructure.GPIO_Mode = GPIO_Mode_IN;
  GPIO_InitStructure.GPIO_PuPd = GPIO_PuPd_NOPULL;
  GPIO_InitStructure.GPIO_Pin = BUTTON_PIN[Button];
  GPIO_Init(BUTTON_PORT[Button], &GPIO_InitStructure);

  if (Button_Mode == BUTTON_MODE_EXTI)
  {
    /* Connect Button EXTI Line to Button GPIO Pin */
    SYSCFG_EXTILineConfig(BUTTON_PORT_SOURCE[Button], BUTTON_PIN_SOURCE[Button]);

    /* Configure Button EXTI line */
    EXTI_InitStructure.EXTI_Line = BUTTON_EXTI_LINE[Button];
    EXTI_InitStructure.EXTI_Mode = EXTI_Mode_Interrupt;

    EXTI_InitStructure.EXTI_Trigger = EXTI_Trigger_Falling;    

    EXTI_InitStructure.EXTI_LineCmd = ENABLE;
    EXTI_Init(&EXTI_InitStructure);

    /* Enable and set Button EXTI Interrupt to the lowest priority */
    NVIC_InitStructure.NVIC_IRQChannel = BUTTON_IRQn[Button];
    NVIC_InitStructure.NVIC_IRQChannelPriority = 0x03;
    NVIC_InitStructure.NVIC_IRQChannelCmd = ENABLE;

    NVIC_Init(&NVIC_InitStructure); 
  }
}

/**
  * @brief  Returns the selected Button state.
  * @param  Button: Specifies the Button to be checked.
  *          This parameter can be one of following parameters:
  *            @arg BUTTON1: Button1 Push Button
  *            @arg BUTTON2: Button2 Push Button   
  * @retval The Button GPIO pin value.
  */
uint32_t HK_EVAL_PBGetState(Button_TypeDef Button)
{
  /* There is one Wakeup button on HK32F0301MG6P7A-EVAL, Button1(KEY1). */
  return GPIO_ReadInputDataBit(BUTTON_PORT[Button], BUTTON_PIN[Button]);
}


/**
  * @brief  Configures COM port.
  * @param  COM: Specifies the COM port to be configured.
  *          This parameter can be one of following parameters:    
  *            @arg COM1
  * @param  USART_InitStruct: pointer to a USART_InitTypeDef structure that
  *         contains the configuration information for the specified USART peripheral.
  * @retval None
  */
void HK_EVAL_COMInit(COM_TypeDef COM, UART_InitTypeDef* UART_InitStruct)
{
  GPIO_InitTypeDef GPIO_InitStructure;

  /* Enable GPIO clock */
  RCC_AHBPeriphClockCmd(COM_TX_PORT_CLK[COM] | COM_RX_PORT_CLK[COM], ENABLE);

  /* Enable USART clock */
  RCC_APBPeriph2ClockCmd(COM_USART_CLK[COM], ENABLE); 

  /* Connect PXx to UARTx_Tx */
  GPIO_PinAFConfig(COM_TX_PORT[COM], COM_TX_PIN_SOURCE[COM], COM_TX_AF[COM]);

  /* Connect PXx to UARTx_Rx */
  GPIO_PinAFConfig(COM_RX_PORT[COM], COM_RX_PIN_SOURCE[COM], COM_RX_AF[COM]);
  
  /* Configure USART Tx as alternate function push-pull */
  GPIO_InitStructure.GPIO_Pin = COM_TX_PIN[COM];
  GPIO_InitStructure.GPIO_Mode = GPIO_Mode_AF;
  GPIO_InitStructure.GPIO_Speed = GPIO_Speed_10MHz;
  GPIO_InitStructure.GPIO_OType = GPIO_OType_PP;
  GPIO_InitStructure.GPIO_PuPd = GPIO_PuPd_UP;
  GPIO_Init(COM_TX_PORT[COM], &GPIO_InitStructure);
    
  /* Configure USART Rx as alternate function push-pull */
  GPIO_InitStructure.GPIO_Pin = COM_RX_PIN[COM];
  GPIO_Init(COM_RX_PORT[COM], &GPIO_InitStructure);

  /* UART configuration */
  UART_Init(COM_UART[COM], UART_InitStruct);
    
  /* Enable USART */
  UART_Cmd(COM_UART[COM], ENABLE);
}

/**
  * @brief  DeInitializes the peripherals used by the SPI FLASH driver.
  * @param  None
  * @retval None
  */
void sFLASH_LowLevel_DeInit(void)
{
  GPIO_InitTypeDef GPIO_InitStructure;

  /*!< Disable the sFLASH_SPI  */
  SPI_Cmd(sFLASH_SPI, DISABLE);
  
  /*!< DeInitializes the sFLASH_SPI */
  SPI_DeInit(sFLASH_SPI);
  
  /*!< sFLASH_SPI Periph clock disable */
  RCC_APBPeriph2ClockCmd(sFLASH_SPI_CLK, DISABLE);
  
  /*!< Configure sFLASH_SPI pins: SCK */
  GPIO_InitStructure.GPIO_Pin = sFLASH_SPI_SCK_PIN;
  
  GPIO_Init(sFLASH_SPI_SCK_GPIO_PORT, &GPIO_InitStructure);

  /*!< Configure sFLASH_SPI pins: MISO */
  GPIO_InitStructure.GPIO_Pin = sFLASH_SPI_MISO_PIN;
  GPIO_Init(sFLASH_SPI_MISO_GPIO_PORT, &GPIO_InitStructure);

  /*!< Configure sFLASH_SPI pins: MOSI */
  GPIO_InitStructure.GPIO_Pin = sFLASH_SPI_MOSI_PIN;
  GPIO_Init(sFLASH_SPI_MOSI_GPIO_PORT, &GPIO_InitStructure);

  /*!< Configure sFLASH_CS_PIN pin: sFLASH Card CS pin */
  GPIO_InitStructure.GPIO_Pin = sFLASH_CS_PIN;
  GPIO_InitStructure.GPIO_Mode = GPIO_Mode_OUT;
  GPIO_Init(sFLASH_CS_GPIO_PORT, &GPIO_InitStructure);
}

/**
  * @brief  Initializes the peripherals used by the SPI FLASH driver.
  * @param  None
  * @retval None
  */
void sFLASH_LowLevel_Init(void)
{
  GPIO_InitTypeDef GPIO_InitStructure;

  /*!< sFLASH_SPI_CS_GPIO, sFLASH_SPI_MOSI_GPIO, sFLASH_SPI_MISO_GPIO 
       and sFLASH_SPI_SCK_GPIO Periph clock enable */
  RCC_AHBPeriphClockCmd(sFLASH_CS_GPIO_CLK | sFLASH_SPI_MOSI_GPIO_CLK | sFLASH_SPI_MISO_GPIO_CLK |
                         sFLASH_SPI_SCK_GPIO_CLK, ENABLE);

  /*!< sFLASH_SPI Periph clock enable */
  RCC_APBPeriph2ClockCmd(sFLASH_SPI_CLK, ENABLE);
  
  GPIO_PinAFConfig(sFLASH_SPI_SCK_GPIO_PORT,sFLASH_SPI_SCK_GPIO_PinSource,sFLASH_SPI_SCK_GPIO_AF);
  GPIO_PinAFConfig(sFLASH_SPI_MISO_GPIO_PORT,sFLASH_SPI_MISO_GPIO_PinSource,sFLASH_SPI_MISO_GPIO_AF);
  GPIO_PinAFConfig(sFLASH_SPI_MOSI_GPIO_PORT,sFLASH_SPI_MOSI_GPIO_PinSource,sFLASH_SPI_MOSI_GPIO_AF);
  
  /*!< Configure sFLASH_SPI pins: SCK */
  GPIO_InitStructure.GPIO_Pin = sFLASH_SPI_SCK_PIN;
  GPIO_InitStructure.GPIO_Mode = GPIO_Mode_AF;
  GPIO_InitStructure.GPIO_OType = GPIO_OType_PP;
  GPIO_InitStructure.GPIO_PuPd = GPIO_PuPd_NOPULL;
  GPIO_InitStructure.GPIO_Speed = GPIO_Speed_10MHz;
  GPIO_InitStructure.GPIO_Schmit = GPIO_Schmit_Disable;
  GPIO_Init(sFLASH_SPI_SCK_GPIO_PORT, &GPIO_InitStructure);

  /*!< Configure sFLASH_SPI pins: MOSI */
  GPIO_InitStructure.GPIO_Pin = sFLASH_SPI_MOSI_PIN;
  GPIO_Init(sFLASH_SPI_MOSI_GPIO_PORT, &GPIO_InitStructure);

  /*!< Configure sFLASH_SPI pins: MISO */
  GPIO_InitStructure.GPIO_Pin = sFLASH_SPI_MISO_PIN;
  GPIO_Init(sFLASH_SPI_MISO_GPIO_PORT, &GPIO_InitStructure);
  
  /*!< Configure sFLASH_CS_PIN pin: sFLASH Card CS pin */
  GPIO_InitStructure.GPIO_Pin = sFLASH_CS_PIN;
  GPIO_InitStructure.GPIO_Mode = GPIO_Mode_OUT;
  GPIO_Init(sFLASH_CS_GPIO_PORT, &GPIO_InitStructure);
}


/**
  * @brief  DeInitializes peripherals used by the I2C EEPROM driver.
  * @param  None
  * @retval None
  */
void sEE_LowLevel_DeInit(void)
{
  GPIO_InitTypeDef  GPIO_InitStructure; 
   
  /* sEE_I2C Peripheral Disable */
  I2C_Cmd(sEE_I2C, DISABLE);
 
  /* sEE_I2C DeInit */
  I2C_DeInit(sEE_I2C);

  /* sEE_I2C Periph clock disable */
  RCC_APBPeriph1ClockCmd(sEE_I2C_CLK, DISABLE);
    
  /* GPIO configuration */  
  /* Configure sEE_I2C pins: SCL */
  GPIO_InitStructure.GPIO_Pin = sEE_I2C_SCL_PIN;
  GPIO_InitStructure.GPIO_Mode = GPIO_Mode_IN;
  GPIO_InitStructure.GPIO_PuPd = GPIO_PuPd_NOPULL;
  GPIO_Init(sEE_I2C_SCL_GPIO_PORT, &GPIO_InitStructure);

  /* Configure sEE_I2C pins: SDA */
  GPIO_InitStructure.GPIO_Pin = sEE_I2C_SDA_PIN;
  GPIO_Init(sEE_I2C_SDA_GPIO_PORT, &GPIO_InitStructure);
}

/**
  * @brief  Initializes the I2C source clock and IOs used to drive the EEPROM.
  * @param  None
  * @retval None
  */
void sEE_LowLevel_Init(void)
{
  GPIO_InitTypeDef  GPIO_InitStructure;
  
  /* Configure the I2C clock source. The clock is derived from the HSI */
  RCC_I2CCLKConfig(RCC_I2C1CLK_SYSCLK);
    
  /* sEE_I2C_SCL_GPIO_CLK and sEE_I2C_SDA_GPIO_CLK Periph clock enable */
  RCC_AHBPeriphClockCmd(sEE_I2C_SCL_GPIO_CLK | sEE_I2C_SDA_GPIO_CLK, ENABLE);
  
  /* sEE_I2C Periph clock enable */
  RCC_APBPeriph1ClockCmd(sEE_I2C_CLK, ENABLE);
  
  /* Connect PXx to I2C_SCL*/
  GPIO_PinAFConfig(sEE_I2C_SCL_GPIO_PORT, sEE_I2C_SCL_SOURCE, sEE_I2C_SCL_AF);
  
  /* Connect PXx to I2C_SDA*/
  GPIO_PinAFConfig(sEE_I2C_SDA_GPIO_PORT, sEE_I2C_SDA_SOURCE, sEE_I2C_SDA_AF);
  
  /* GPIO configuration */  
  /* Configure sEE_I2C pins: SCL */
  GPIO_InitStructure.GPIO_Pin = sEE_I2C_SCL_PIN;
  GPIO_InitStructure.GPIO_Mode = GPIO_Mode_AF;
  GPIO_InitStructure.GPIO_Speed = GPIO_Speed_2MHz;
  GPIO_InitStructure.GPIO_OType = GPIO_OType_OD;
  GPIO_InitStructure.GPIO_PuPd = GPIO_PuPd_NOPULL;
  GPIO_Init(sEE_I2C_SCL_GPIO_PORT, &GPIO_InitStructure);
  
  /* Configure sEE_I2C pins: SDA */
  GPIO_InitStructure.GPIO_Pin = sEE_I2C_SDA_PIN;
  GPIO_Init(sEE_I2C_SDA_GPIO_PORT, &GPIO_InitStructure);
}



/**
  * @}
  */ 

/**
  * @}
  */ 

/**
  * @}
  */

/**
  * @}
  */

/**
  * @}
  */ 
    
