Gelow-serafind/Homogenizer-Proj-ES-motor/Proj/inc/hk32f0301mxxc_it.h

/*******************************************************************************
* @copyright: Shenzhen Hangshun Chip Technology R&D Co., Ltd
* @filename:  hk32f0301mxxc_it.h
* @brief:     Interrupt Service Routines
* @author:    AE Team
*******************************************************************************/


/* Define to prevent recursive inclusion -------------------------------------*/
#ifndef __HK32F0301MxxC_IT_H
#define __HK32F0301MxxC_IT_H

#ifdef __cplusplus
extern "C" {
#endif 

/* Includes ------------------------------------------------------------------*/
#include "main.h"

/* Exported types ------------------------------------------------------------*/
/* Exported constants --------------------------------------------------------*/
/* Exported macro ------------------------------------------------------------*/
/* Exported functions ------------------------------------------------------- */

void NMI_Handler(void);
void HardFault_Handler(void);
void SVC_Handler(void);
void PendSV_Handler(void);
// void SysTick_Handler(void);

#ifdef __cplusplus
}
#endif

#endif /*__HK32F0301MxxC_IT_H */
