Gelow-serafind/Homogenizer-Proj-ES-motor/Proj/src/hk32f0301mxxc_it.c

/*******************************************************************************
* @copyright: Shenzhen Hangshun Chip Technology R&D Co., Ltd
* @filename:  hk32f0301mxxc_it.c
* @brief:     Interrupt Service Routines
* @author:    AE Team
* @version:   V1.0.0/2025-07-16
*             1.Initial version
* @log:
*******************************************************************************/


/* Includes ------------------------------------------------------------------*/
#include "hk32f0301mxxc_it.h"

/* Private typedef -----------------------------------------------------------*/
/* Private define ------------------------------------------------------------*/
/* Private macro -------------------------------------------------------------*/
/* Private variables ---------------------------------------------------------*/
/* Private function prototypes -----------------------------------------------*/
/* Private functions ---------------------------------------------------------*/

/******************************************************************************/
/*            Cortex-M0 Processor Exceptions Handlers                         */
/******************************************************************************/

/**
  * @brief  This function handles NMI exception.
  * @param  None
  * @retval None
  */
void NMI_Handler(void)
{
}

/**
  * @brief  This function handles Hard Fault exception.
  * @param  None
  * @retval None
  */
void HardFault_Handler(void)
{
  /* Go to infinite loop when Hard Fault exception occurs */
  while (1)
  {
  }
}

/**
  * @brief  This function handles SVCall exception.
  * @param  None
  * @retval None
  */
void SVC_Handler(void)
{
}

/**
  * @brief  This function handles PendSVC exception.
  * @param  None
  * @retval None
  */
void PendSV_Handler(void)
{
}

/**
  * @brief  This function handles SysTick Handler.
  * @param  None
  * @retval None
  */
// void SysTick_Handler(void)
// {
// }

/******************************************************************************/
/*             HK32F0301MxxC Peripherals Interrupt Handlers                   */
/*  Add here the Interrupt Handler for the used peripheral(s) (PPP), for the  */
/*  available peripheral interrupt handler's name please refer to the startup */
/*  file (KEIL_startup_hk32f0301mxxc.s).                                      */
/******************************************************************************/

/**
  * @brief  This function handles PPP interrupt request.
  * @param  None
  * @retval None
  */
/*void PPP_IRQHandler(void)
{
}*/

/**
  * @}
  */
