Gelow-serafind/Homogenizer-Proj-ES-motor/(commit log)

2026-09-07 [ADD]提交仓库
2026-09-07 [ADD]新增硬件文档与固件修改计划
    - ES电机驱动原理图(1).pdf：新板原理图（HK32F0301MF4P7C TSSOP20）
    - es电机需求文档v1-260830.docx：业务需求
    - LVD13083AVTP1-HT1623.pdf：显示屏规格书
    - 修改计划.md：硬件/业务差异分析 + 8阶段实施计划
2026-09-07 [MOD]STEP1：UART 迁至新板引脚并恢复 shell 命令行交互（已验证）
    - UART1 TX/RX 由 PA3/PD6 改为 PD4/PB4（新板调试串口 H1）
    - PWM 迁至 PD6 AF3 @10kHz，删除 PB5→PD2 的 IOMUX 重映射（保护 SWCLK）
    - EC11 改为 PC5/PC3/PC4，下拉输入，按键极性翻转为高有效
    - 新增 STEP1_UART_ONLY 开关：屏蔽 TM1729 显示驱动，占空比钳位为 0
    - 移除验证用 1s 心跳打印，保留规范 shell（help/speed/start/pause/status）
    - Keil 编译器升级 ARMCLANG V6.19→V6.22
2026-09-07 STEP2: HT1623 LCD bring-up done (RC32K) + cleanup debug commands
    - LCD 驱动修正(命令码/RAM组织/位序)后点亮，改内部 RC 32k 振荡器驱动
    (外接 U46 晶振不起振, 待硬件补焊后切回 XTAL32K)
    - 显示/图标映射验证通过; 保留 lcd all|off|d1-28|s1-30 供后续字段映射
    - 移除 bring-up 测试命令 seg/scan/raw/fill/walk/walki 及多余调试打印
    - 精简开机 banner; 删除 Task_App 旋钮调试打印残留
    - Keil 开 -Oz 尺寸优化(修复 16KB Flash 链接溢出, L6406E)
    - 新增 显示屏阶段性问题排查结果.md
2026-09-13 STEP3: 业务状态机重构 + ADS1115 测速链路驱动（归档）
    业务（对照需求 v1-260830）：
    - 四态状态机 STANDBY/RUNNING/PAUSED + 设置叠加层（SPEED→H→M→S 循环，5s 无操作自动确认）
    - 开始/停止键 PA2/PD7（低有效+消抖）；旋钮单击进设置/切字段，步进 10 RPM（100~2000）
    - 倒计时：到达目标后启动、每秒递减、暂停冻结、归零回 STANDBY（归零行为待确认）
    - 显示层：字段布局表 FieldLayout + 图标角色绑定 IconBind(待实测填编号) + 50ms 整屏刷新(变更检测) + 字段闪烁
    - Flash：16×8B 槽存 速度+H-M-S（LoadParams/SaveParams）；命令 speed/time/start/stop/pwm/adc/tach
    -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
2026-09-14 docs: 建立需求-测试-架构文档体系（需求细分拆解 REQ×47、测试用例 TC×57、架构设计、审核报告、产品认知摘要），并重写 CLAUDE.md 开发守则
2026-09-14 STEP4: 模块化重构——main.c 拆分为 app/ 应用框架（9 模块 + 4 驱动 + 事件总线），已上板验证
    - 新增 Proj/app/{inc,src}：event_bus/app_state/display/button/motor/speed_sensor/temp_sensor/timer/storage
    + ht1623/ads1115/ec11/flash_wear 驱动 + app.c 调度框架 + uart_cmd 调试 shell + app_cfg.h 常量集中
    - main.c 2234 行 → 38 行（仅 App_Init/App_Run）；行为与 STEP3/3.5 等价
    （ramp 10ms 时序、消抖、LUT/段位表逐字节一致、Flash 槽格式不变）
    - Keil 工程新增 App 分组（15 文件）与包含路径 ..\app\inc
    - 文档同步：软件架构设计（模块表/调度表/存储/目录结构/实现注记）、CLAUDE.md（模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
2026-09-14 STEP5(旋钮): EC11 升级 EXTI 双边沿硬件捕获，修复快速拨动丢格
    - ec11: PC5=EXTI5、PC3=EXTI3 双边沿触发（SYSCFG 选路+NVIC）；ISR 仅 GPIO 读+查表+1/4 格累加，不发事件
    - 主循环 take_delta ÷4 取整格并保留余量（修复旧版满 ±4 归零吞零头）；±120 格饱和不变
    - 新增 EC11_USE_EXTI 开关（=0 回退 2ms 轮询）；新 shell 命令 knob（isr/edge4x/detent 统计，读后清零）
    - button 语义不变（2ms 消费增量发事件）；EXTI 为独立外设，不占定时器（TIM2/TIM6 仍空闲）
    - 文档同步：软件架构设计（模块表/接口/实现注记#6/事件投递约定/调度依据/免锁根因）、CLAUDE.md（I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
2026-09-14 STEP6: 测速链路归档 + PPR=18 标定；回退 demo，保留最小 PB4/EXTI4 计数实现
    - speed_sensor: PB4(=U15/SPEED_SW，与 USART1_RX 同网络)/EXTI4 单边沿计数
    （ISR 只自增；20ms 任务 500ms 窗口换算 RPM 发 EVT）；新增 get_pulses()；
    ADS1115 骨架与 demo 开关（SPEED_SRC/SPEED_DISPLAY_PULSES）删除
    - app_cfg.h: SPEED_PPR=18（A10 实测）、SPEED_WINDOW_MS=500、EXTI 宏集中
    - demo 回退: display.c 恢复电机模型值显示（原样）；全仓库无 demo/SPEED_SRC 残留
    - 上板记录: 链路验证通 2026-09-14；PPR 标定 18 计数/圈 2026-09-15（1圈18/2圈36/7圈126）
    - 文档: 新增 doc/原理图网络连接说明_V1.0.md；产品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
2026-09-14 STEP7: 电机验证映射 + 解除 MOTOR_DUTY_CLAMP（上板验证转动 OK）
    - motor.c: RpmDutyLUT 替换为验证用简单映射（100→15%、1000→22%、2000→30% 线性；非标定值）
    - app_cfg.h: MOTOR_DUTY_CLAMP 1→0（验证阶段；防止意外动作的防护门改为开放输出）
    - 上板验证: 2026-09-15 旋钮设速 + START，电机正常转动（用户确认）；屏显速度仍为模型值
    - 文档同步: CLAUDE.md / AGENTS.md / 产品认知摘要 R7 / 软件架构设计 R5（标注验证映射）
    - 后续: 实测 100~2000 RPM 占空比曲线回填 LUT（R7/P8）；测速接入屏显（真实 RPM）
2026-09-14 STEP8: 真实测速（周期法）+ 屏显实测 RPM 接入（上板外测仪器核对准确）
2026-09-15 速度环落地：FF(LUT 前馈)+PI 反馈闭环 + A12 到达判定切实测
    motor：20ms 节拍（5ms 内 4 分频，与测速同频）、Q8 定点；反馈经 EVT_SPEED_UPDATED 订阅缓存（新增 EVT_MOD_MOTOR，无模块间直调）；参考轨迹=原 ramp；积分限幅抗饱和；输出 0~100% 物理边界（用户决策）；SPEED_LOOP_EN=0 可回退开环（REQ-MOT-01）
    app_state：到达判定切换实测转速 ±50RPM/1s（A12，REQ-MOT-03）
    display：圆图标数据源切实测转速
    shell：新增 pid/pidkp/pidki 整定命令
    上板修复：motor_set_target 不清积分（消除运行中调速大幅抖动）
    文档同步：REQ-MOT-01、TC-MOT-01/03 更新 + TC-MOT-06 新增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
2026-09-15 屏显转速显示层二次平滑：稳态防跳字，控制链不受影响
    display：Instant Speed 增加变速跟随滤波（display_smooth_speed，50ms 拍）——
    |原始−显示|>30RPM 每拍逼近一半（调速不迟钝）、稳态 1/8 强平滑（τ≈0.4s，
    向零截断自带 ±8RPM 显示死区）、停转立即归零；圆图标同用平滑值（无帧滞后）。
    speed_sensor 原始反馈不动：PID/A12 依赖其带宽，加重会失配。
    常量：DISP_SPEED_JUMP_RPM=30 / DISP_SPEED_SS_DIV=8（app_cfg.h）。
    文档：架构 §8 显示来源表 + 实现注记 10。
2026-09-16 温度全链路实装（比值法+查表+0.1℃显示）+ 屏段位 30/30 实测校准
    temp_sensor：原理图核实电路（VCC_5V-R16(1k)-探头-GND，AIN0=探头节点/AIN1=基准中点）；
    比值法 R_t=1000×A0/(2×A1−A0)（免疫电源波动）；IEC 60751 查表 0~300℃/5℃ 步进
    +线性插值（零浮点）；在位检测（TEMP_DEN_MIN+2 次去抖）；templog 调试命令。
    （REQ-TEMP-01/02/03）
    display：温度 0.1℃ 全格式（点 S28/℃ S29/标签 S26-27 随探头隐藏）；
    段位语义 30/30 实测落地（lcd sweep）——常显 22 段（标签/单位/S10-19 十条隔断线）、
    图标绑定（时钟 S1/十字架 S30/圆 S4/▲ S3）；新增 lcd sweep 轮扫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
2026-09-16 修正 digit 字段布局实测错位 + 温度占位 25.8℃
    - display: 字段布局按四路交叉实测修正（Remaining=位17-24 连续 H4:M2:S2、
    InstTemp=位25-28）；原推断初值中温度[17-20]与 Remaining[21-28]整体错位。
    确认方式：SetTime=2h24m33s + 占位 25.8 交叉验证内容物落点。
    Set Time/Remaining H 改 4 位补零（draw_number_pad，TC-DISP-03 口径）；
    新增温度占位绘制分支；删除废弃 draw_time_field。
    - app_cfg: 新增 TEMP_DISPLAY_PLACEHOLDER=1 + TEMP_PLACEHOLDER_T10=258
    （探头硬件未到，2026-09-16 用户指令；到位后切 0 恢复真实值+拔出隐藏 REQ-DISP-06）
    - temp_sensor: 在位判定去抖简化（50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
2026-09-16 时钟 START 即亮 + 倒计时改 START 直启（2026-09-17 用户上板验收）
    - display: 时钟图标改由 RUNNING 状态驱动——START 即亮（含加速段）、暂停/待机/停止灭
    （2026-09-16 实测修正，取代"到达目标后才亮"；按需求简述 3 节"电机转动后时钟图标点亮"）
    REQ-ICON-02 / TC-ICON-02
    - timer: 解除 EVT_REACH_TARGET 订阅（递减不再由到达触发，仅剩 EVT_1S 节拍消费）
    - app_state: 倒计时改"START 立即开始 / STOP 立即冻结"（2026-09-17 用户实测决策，
    取代"实际转速到达目标后才倒数"）：
    · 全新启动从设定值开始、暂停恢复从冻结值继续、改过时间按新值重载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
2026-09-16 修复 STOP 后重启大电流冲击：参考轨迹按实测转速复位
    - motor: motor_set_target 从停机状态（enabled=0）起飞时，参考轨迹 outRpm
    从实测转速复位（无阶跃），不再沿用 STOP 后的残留衰减值——原实现 STOP 后
    outRpm 以 1000 RPM/s 向 0 衰减（约 2s 归零），2s 内重启时 outRpm 残留
    1500+ 而电机已停 → FF(LUT)+P+I 输出 60%+ 占空比砸向静止电机
    （2026-09-17 上板实测 bug：爬升正常，STOP 后立即 START 大电流猛启动）
    - RUNNING 中改目标不受影响（enabled==1 不覆盖）；PAUSED 惯性旋转中重启
    可从实测无缝接续；倒计时归零/冷启动路径不受影响
    - doc: T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
2026-10-01 屏显转速吸附锁定（±2进/±15出+4拍去抖）+ 温度切实值上线（2026-10-01）
    - display：RUNNING 实测连续4拍进入目标±2 RPM→吸附锁定显示目标值；
    连续4拍偏离超±15→回退实时显示；切换当拍 dispSpeed 对齐（防跳变/无滞后）
    - TEMP_DISPLAY_PLACEHOLDER 0：探头接入切实值显示（拔出整块隐藏 REQ-DISP-06）
    - 文档同步：架构注记13/显示数据源表/CLAUDE/AGENTS/需求/审核
2026-10-01 温度链路收尾：均值滤波 + 分度表切 A=3.862e-3 + 线性标定参数（2026-10-01）
    - temp_sensor：8 点滑动平均（500ms×8=4s 窗，TEMP_AVG_WINDOW），插拔清窗/
    插入首拍满窗装载；templog 打印 Traw/Tavg 双值
    - 分度表按参考项目 magnetic_stir_heat_v5.0 统一为 A=3.862e-3 老分度
    （原 IEC 60751 3.9083e-3 弃用；100℃ 差 ≈1.2℃）；300℃ 钳位 2120→2106Ω
    - 新增线性标定层：T_cal=T_raw×TEMP_CAL_GAIN_PPT/1000+TEMP_CAL_OFFSET_T10
    （app_cfg.h 集中，默认无修正，改标定无需重新生成分度表）
    - 文档同步：架构注记11/CLAUDE
2026-10-21 UI 图标修正：S1~S4/S30 按屏规格书第 3 页纠正（Set Speed 常显、时钟=RUNNING 且倒计时、感叹号恒灭、圆=RUNNING 且实测>0、暂停立即灭时钟/圆）；display 改 app_state 快照推送 + 单击先确认 + Flash 无变化不写/双 word 同快照 + timer 归零等价改写（2026-10-08）
2026-10-21 移除 tests/ 主机测试脚本并清理 AGENTS.md 引用（2026-10-08 UI 修正收尾）
